twam/led-display-hardware/Rev1.0/led-matrix-cape.pdf

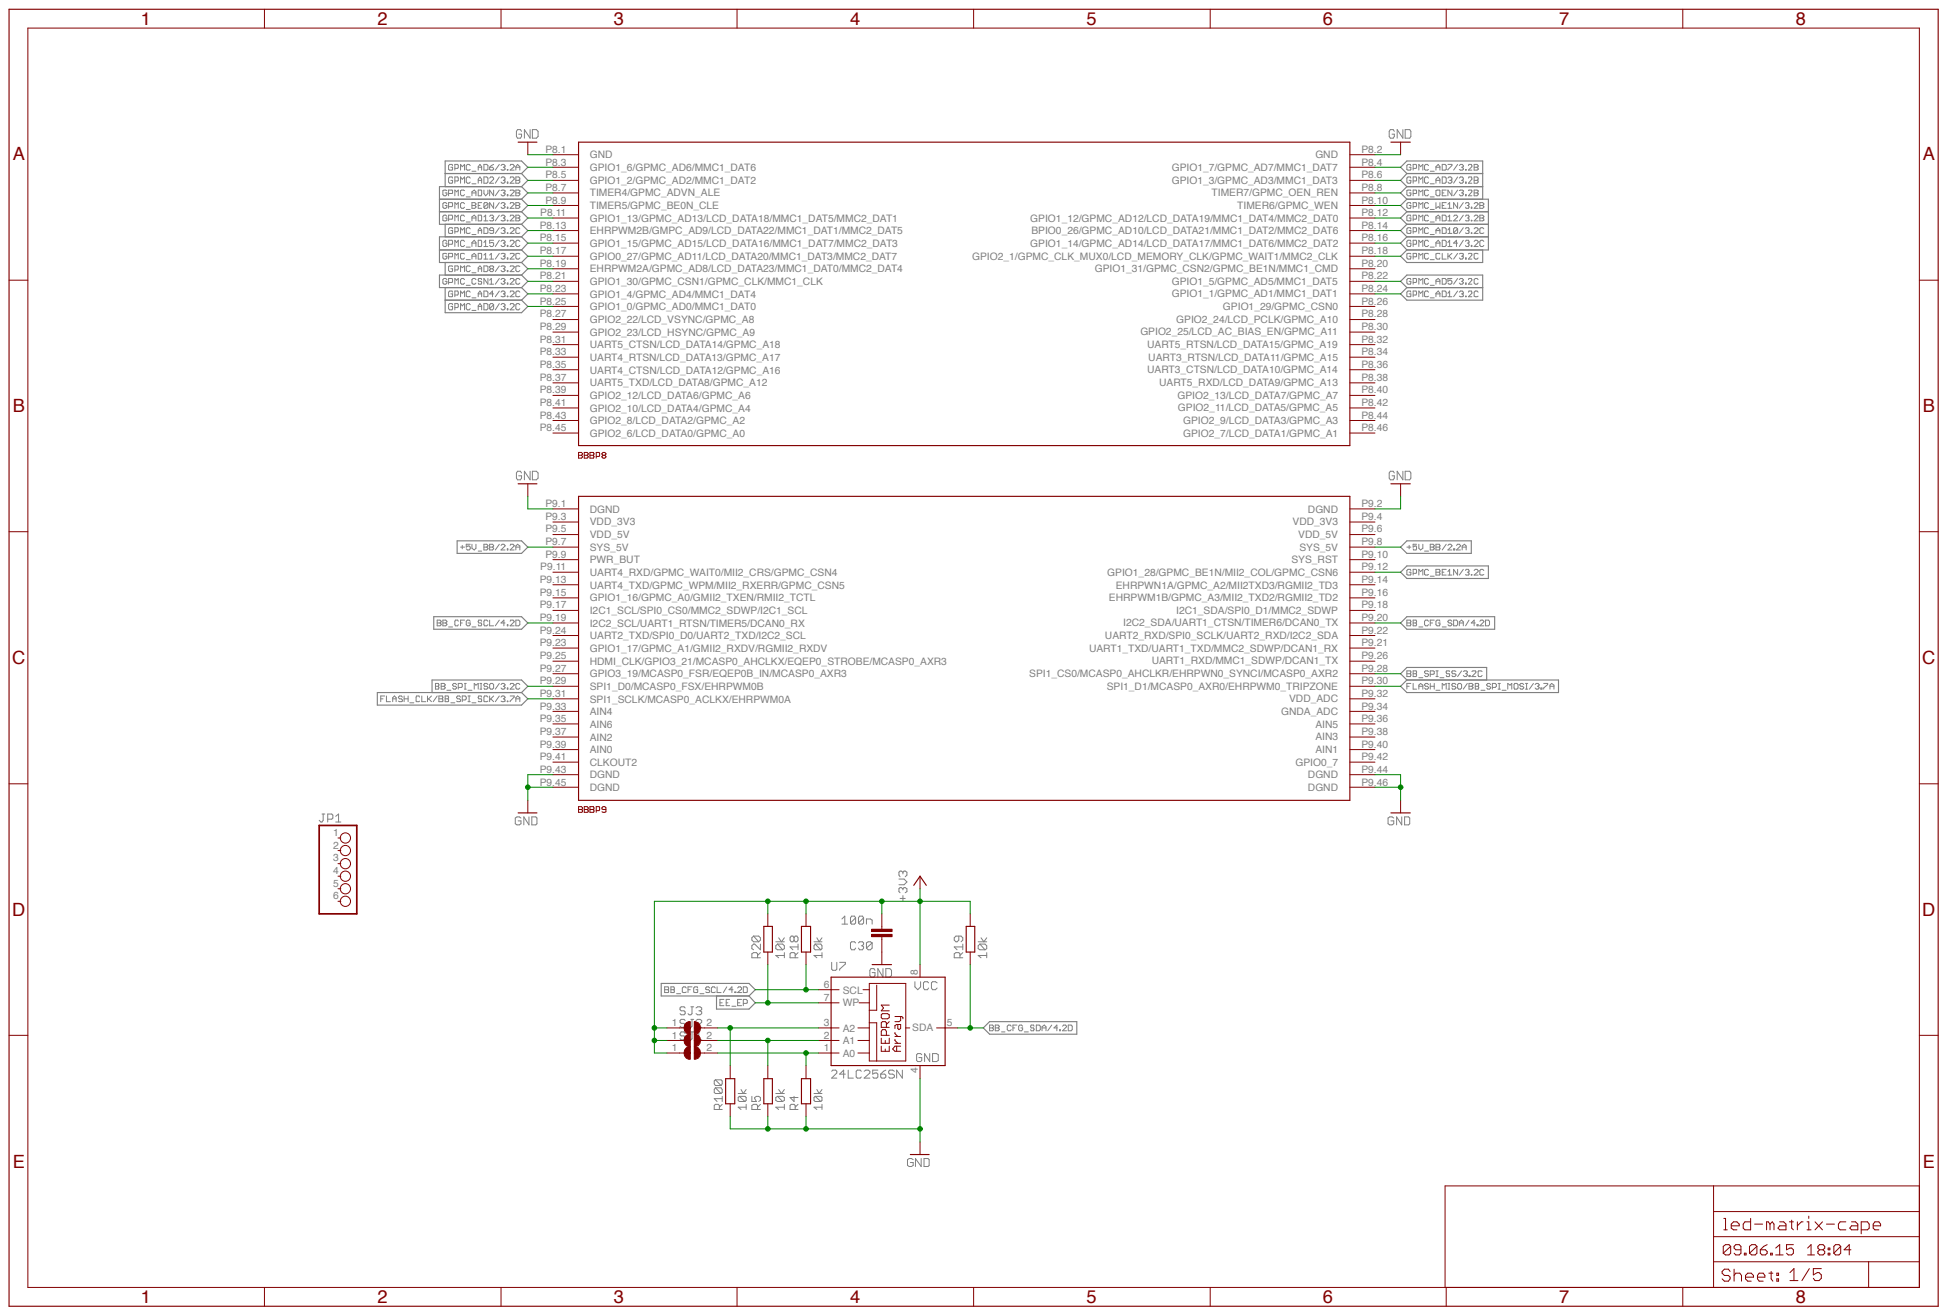
[picture p7: page 1]
SCL; SDA; GND P8.1 GPIO1_6/GPMC_AD6/MMC1_DAT6 P8.3 GPIO1_2/GPMC_AD2/MMC1_DAT2 P8.5 TIMER4/GPMC_ADVN_ALE P8.7 TIMER5/GPMC_BE0N_CLE P8.9 GPIO1_13/GPMC_AD13/LCD_DATA18/MMC1_DAT5/MMC2_DAT1 P8.11 EHRPWM2B/GMPC_AD9/LCD_DATA22/MMC1_DAT1/MMC2_DAT5 P8.13 GPIO1_15/GPMC_AD15/LCD_DATA16/MMC1_DAT7/MMC2_DAT3 P8.15 GPIO0_27/GPMC_AD11/LCD_DATA20/MMC1_DAT3/MMC2_DAT7 P8.17 EHRPWM2A/GPMC_AD8/LCD_DATA23/MMC1_DAT0/MMC2_DAT4 P8.19 GPIO1_30/GPMC_CSN1/GPMC_CLK/MMC1_CLK P8.21; GPIO1_0/GPMC_AD0/MMC1_DAT0 P8.25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

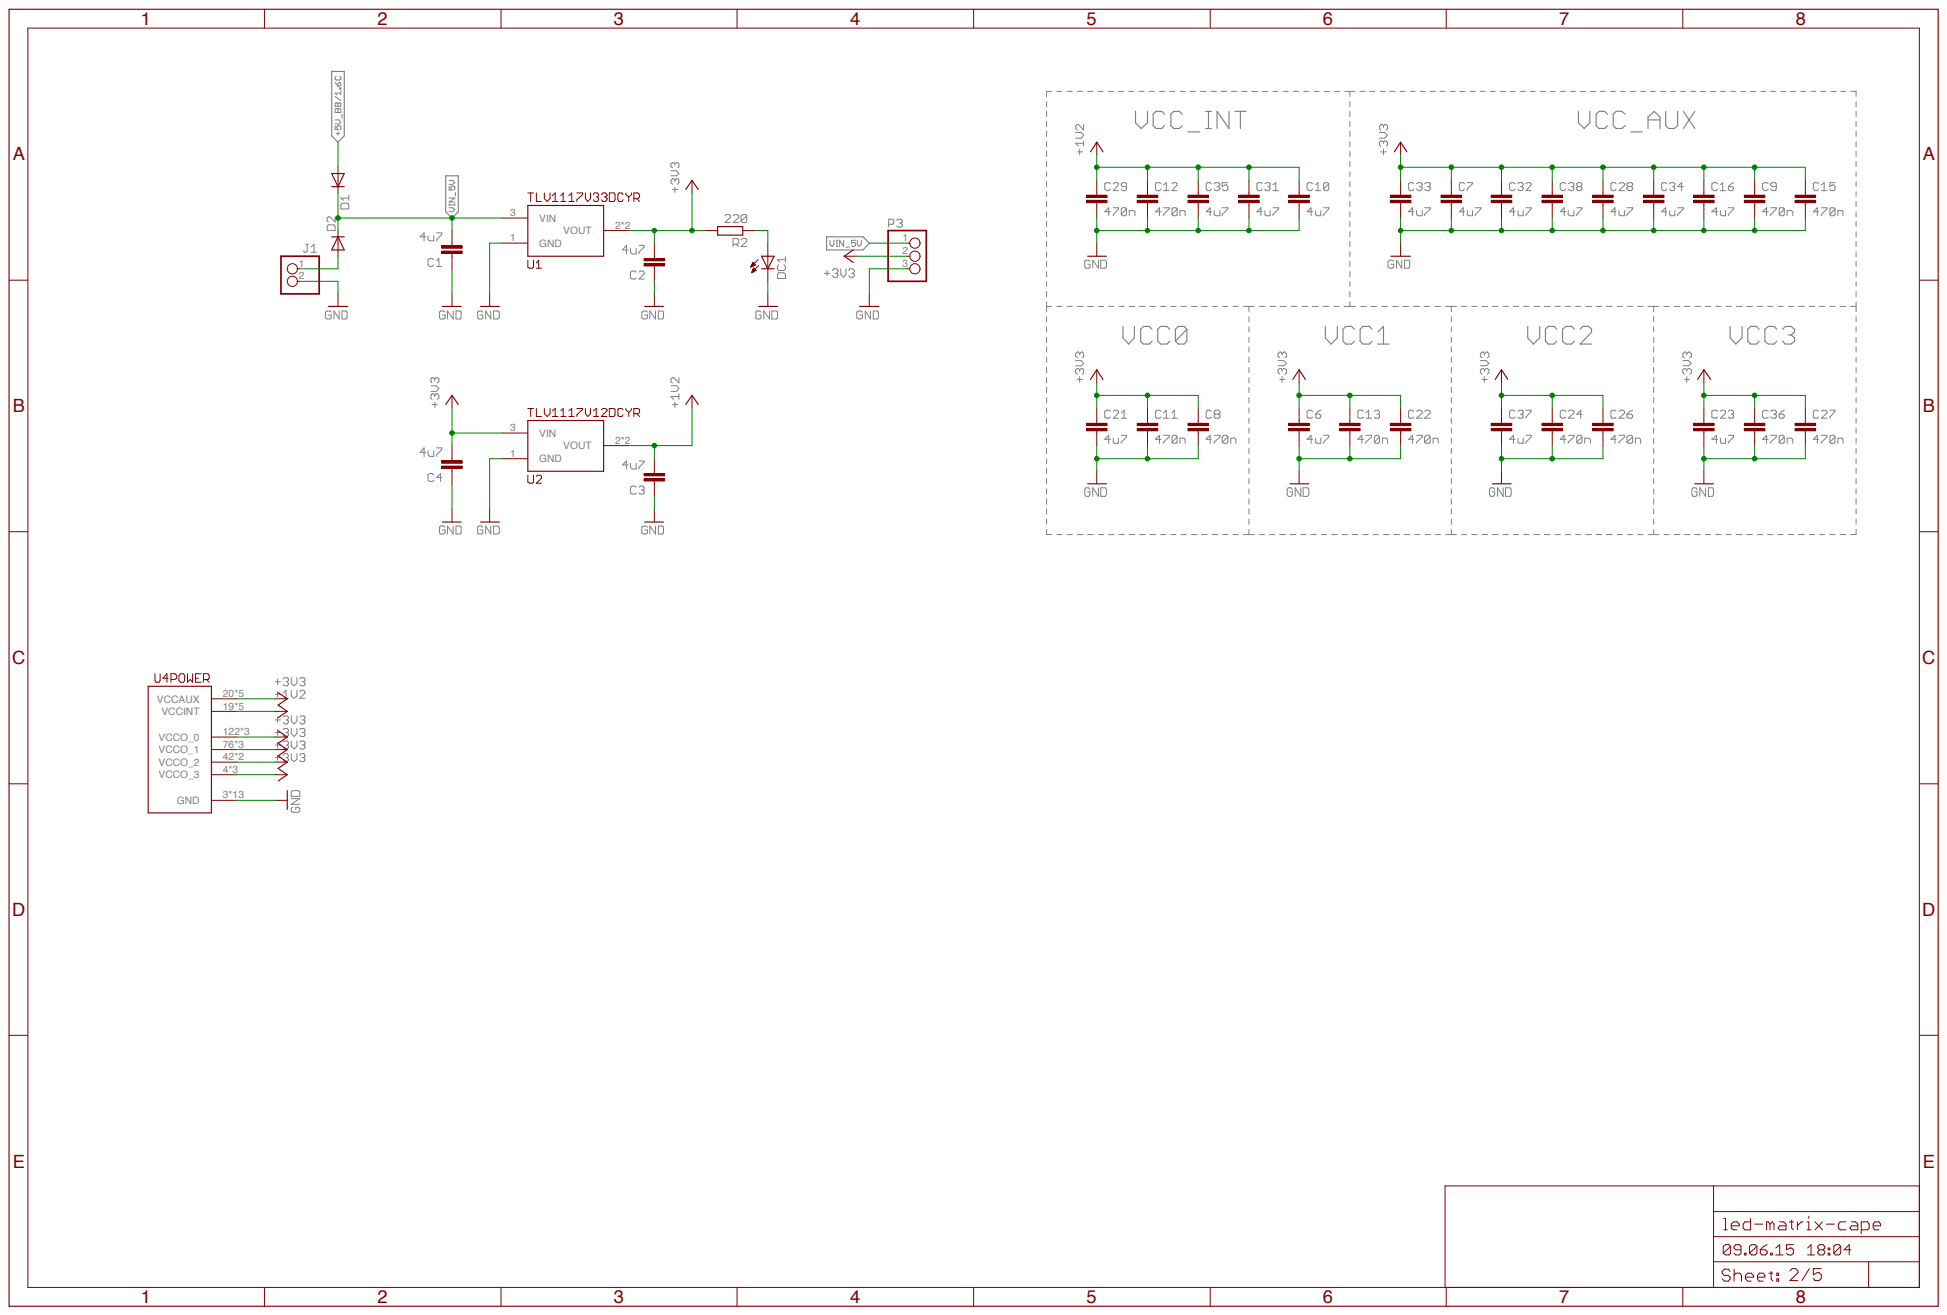
[picture p8: page 2]
GND; VCCAUX; VCCINT; VCCO_1; 76*3 VCCO_0; VCCO_2; VCCO_3; VIN; VOUT; ABCDE

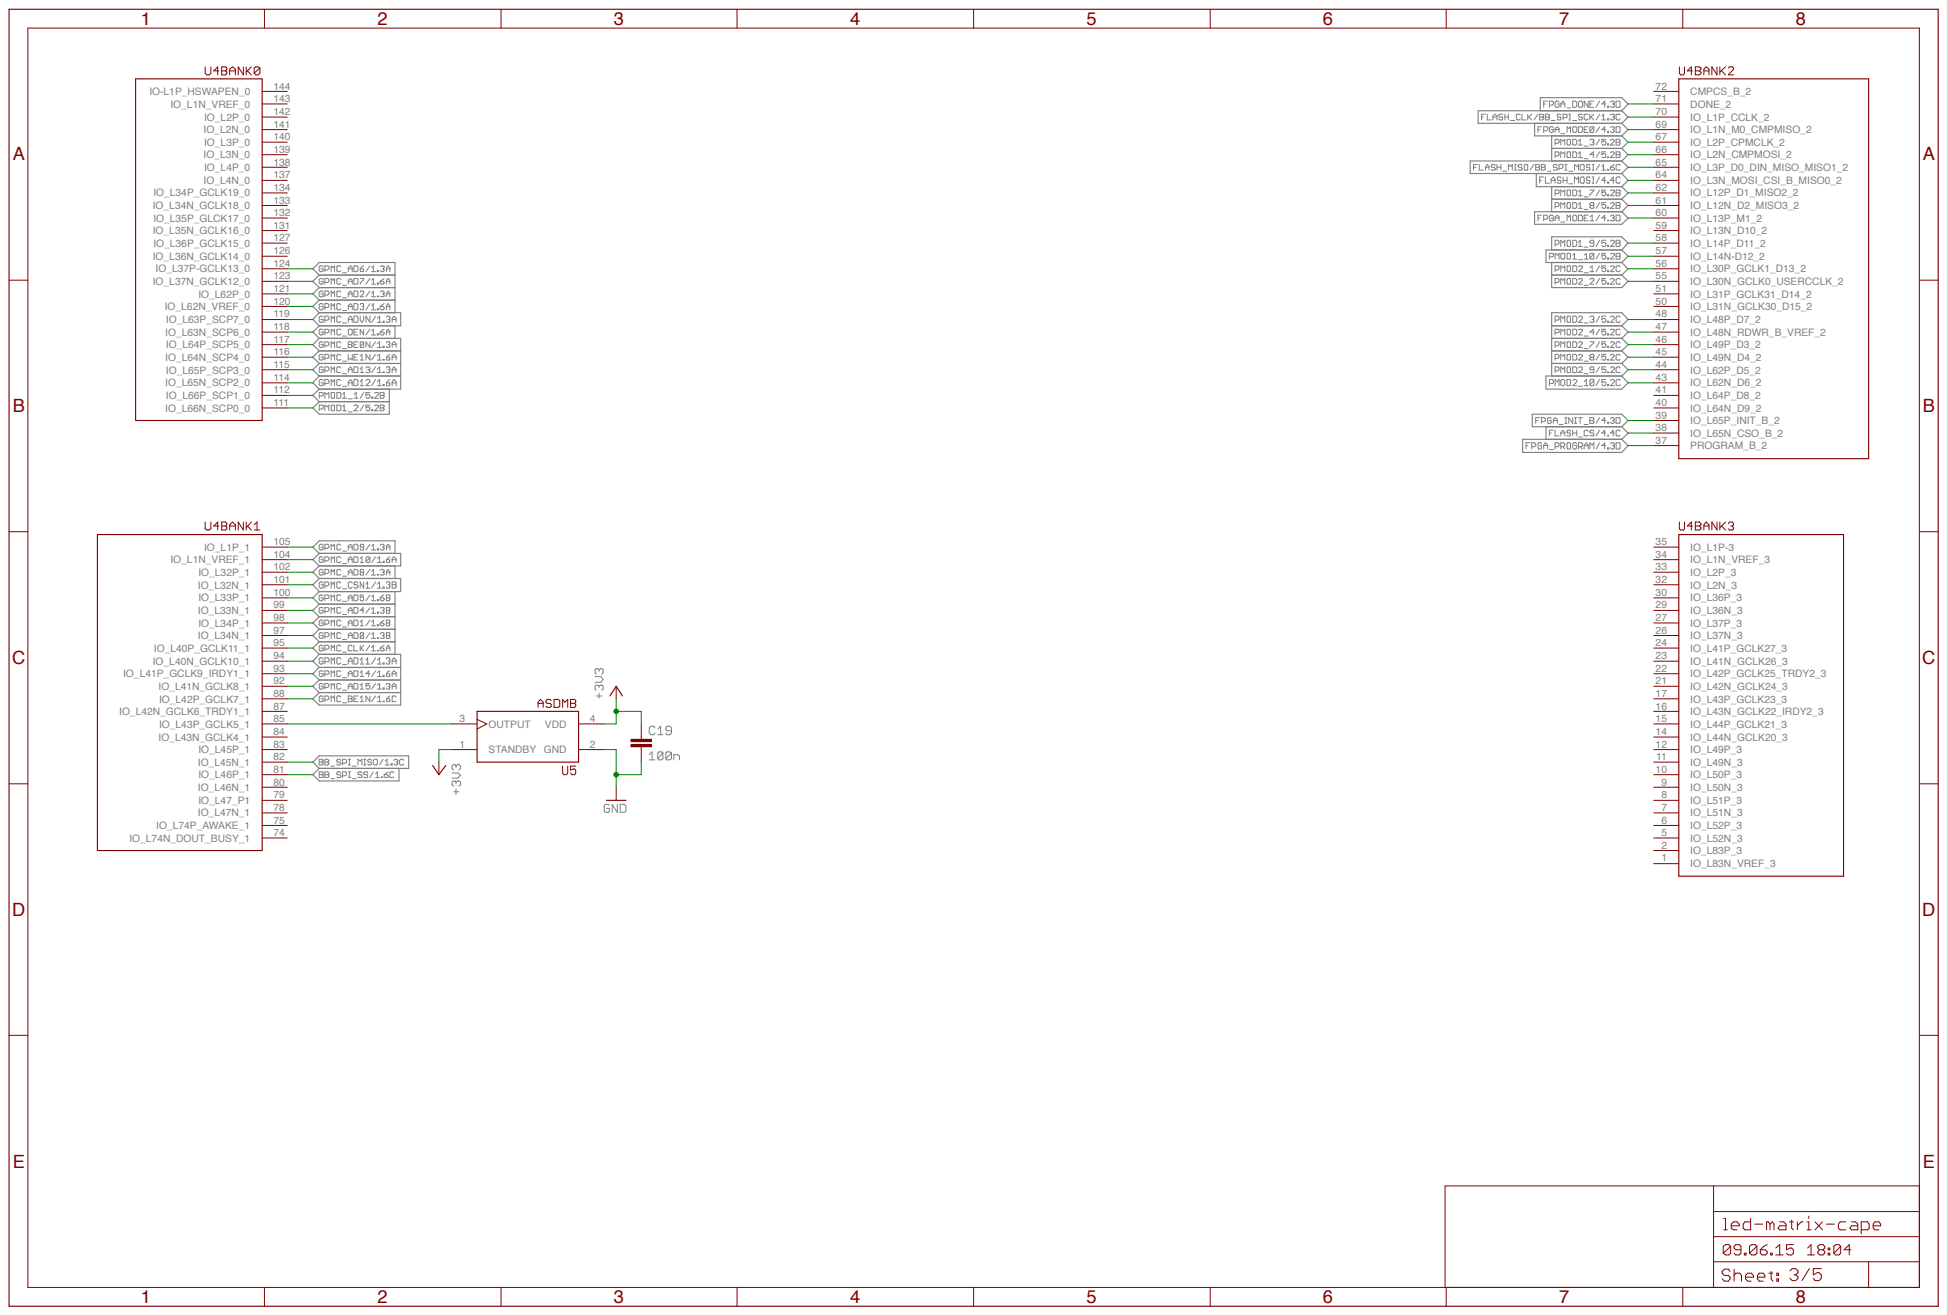
[picture p9: page 3]
IO-L1P_HSWAPEN_0; IO_L1N_VREF_0; IO_L34P_GCLK19_0; IO_L34N_GCLK18_0; IO_L35P_GLCK17_0; IO_L35N_GCLK16_0; IO_L36P_GCLK15_0; IO_L36N_GCLK14_0; IO_L37P-GCLK13_0; IO_L37N_GCLK12_0; IO_L62N_VREF_0; IO_L63P_SCP7_0; IO_L63N_SCP6_0; IO_L64P_SCP5_0; IO_L65P_SCP3_0; IO_L66P_SCP1_0; 112 IO_L65N_SCP2_0; IO_L64N_SCP4_0; IO_L66N_SCP0_0; IO_L1N_VREF_1; IO_L40P_GCLK11_1; IO_L40N_GCLK10_1; IO_L41P_GCLK9_IRDY1_1; IO_L41N_GCLK8_1; IO_L42P_GCLK7_1; IO_L42N_GCLK6_TRDY1_1; IO_L43P_GCLK5_1; IO_L43N_GCLK4_1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

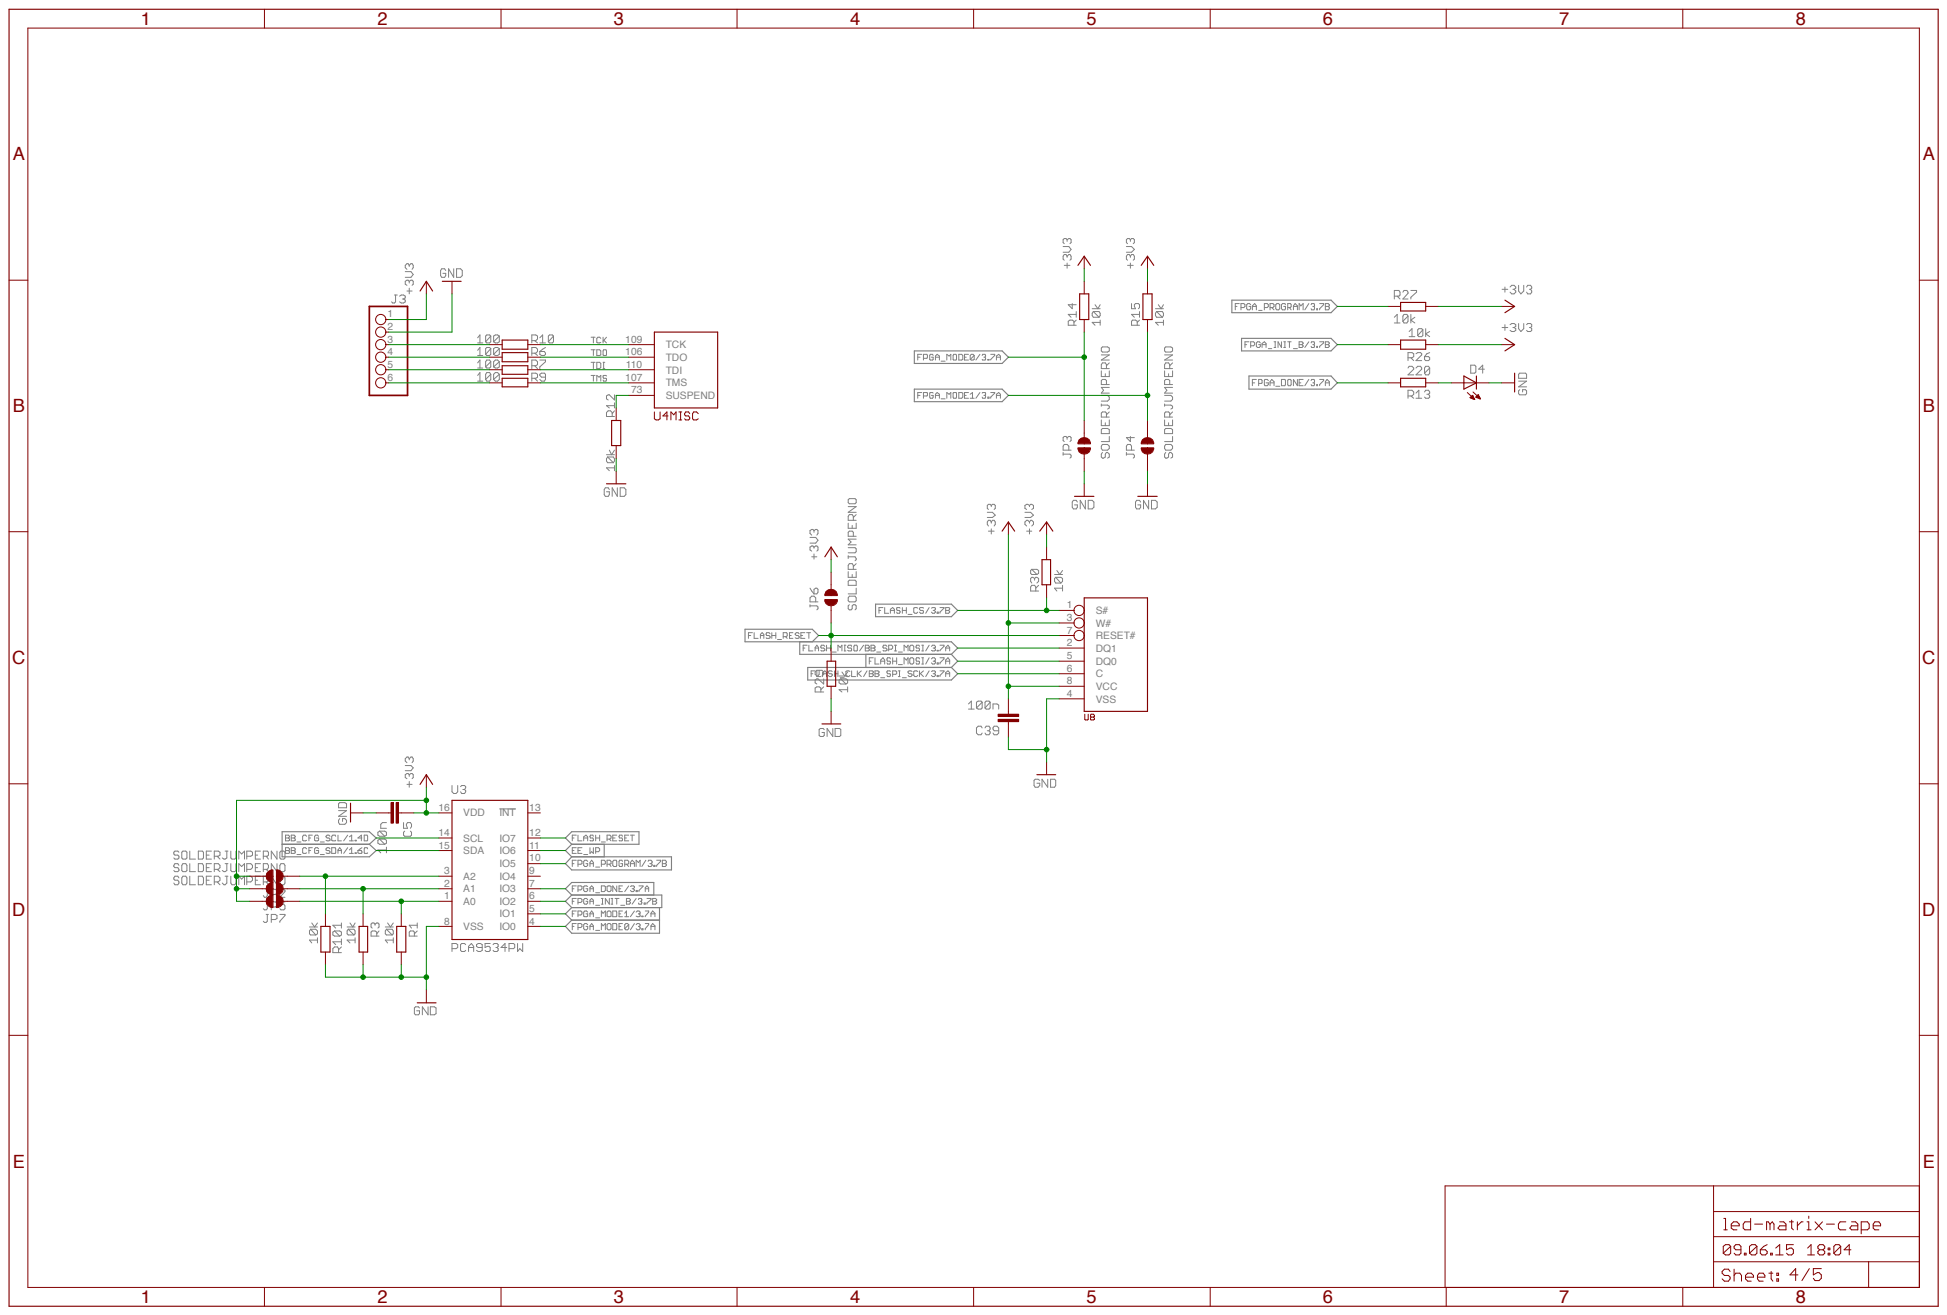
[picture p10: page 4]
RESET#; VCC; VSS; TCK 109; TDI 110; TDO 106; TMS 107 SUSPEND 73; VDD 16; SCL 14 SDA 15; INT; ABCDE

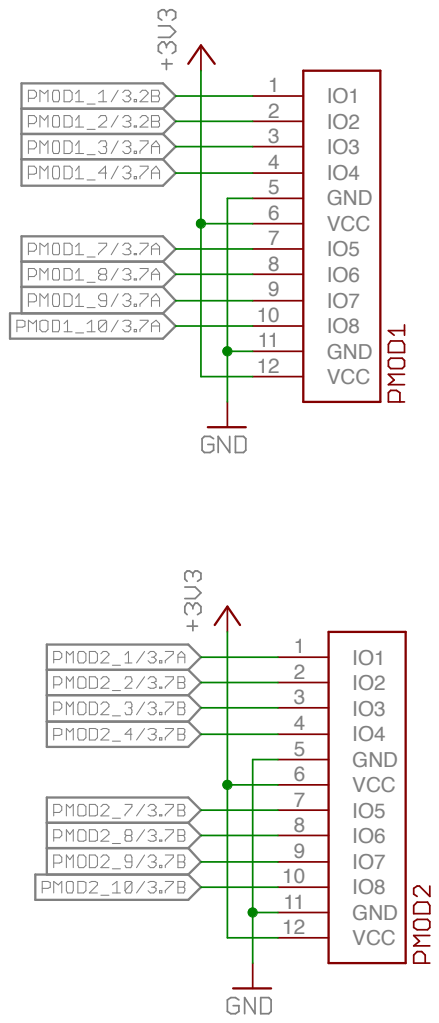
[picture p11: page 5]
GND; VCC; 9 IO8 10 GND 11 VCC 12; VCC 12; ABCDE

IO8 10
GND 11
