twam/led-display-hardware/Rev2.0/Rev2.0.kicad_pcb

## KiCad design Rev2.0/Rev2.0.kicad_pcb (2015-06-09)

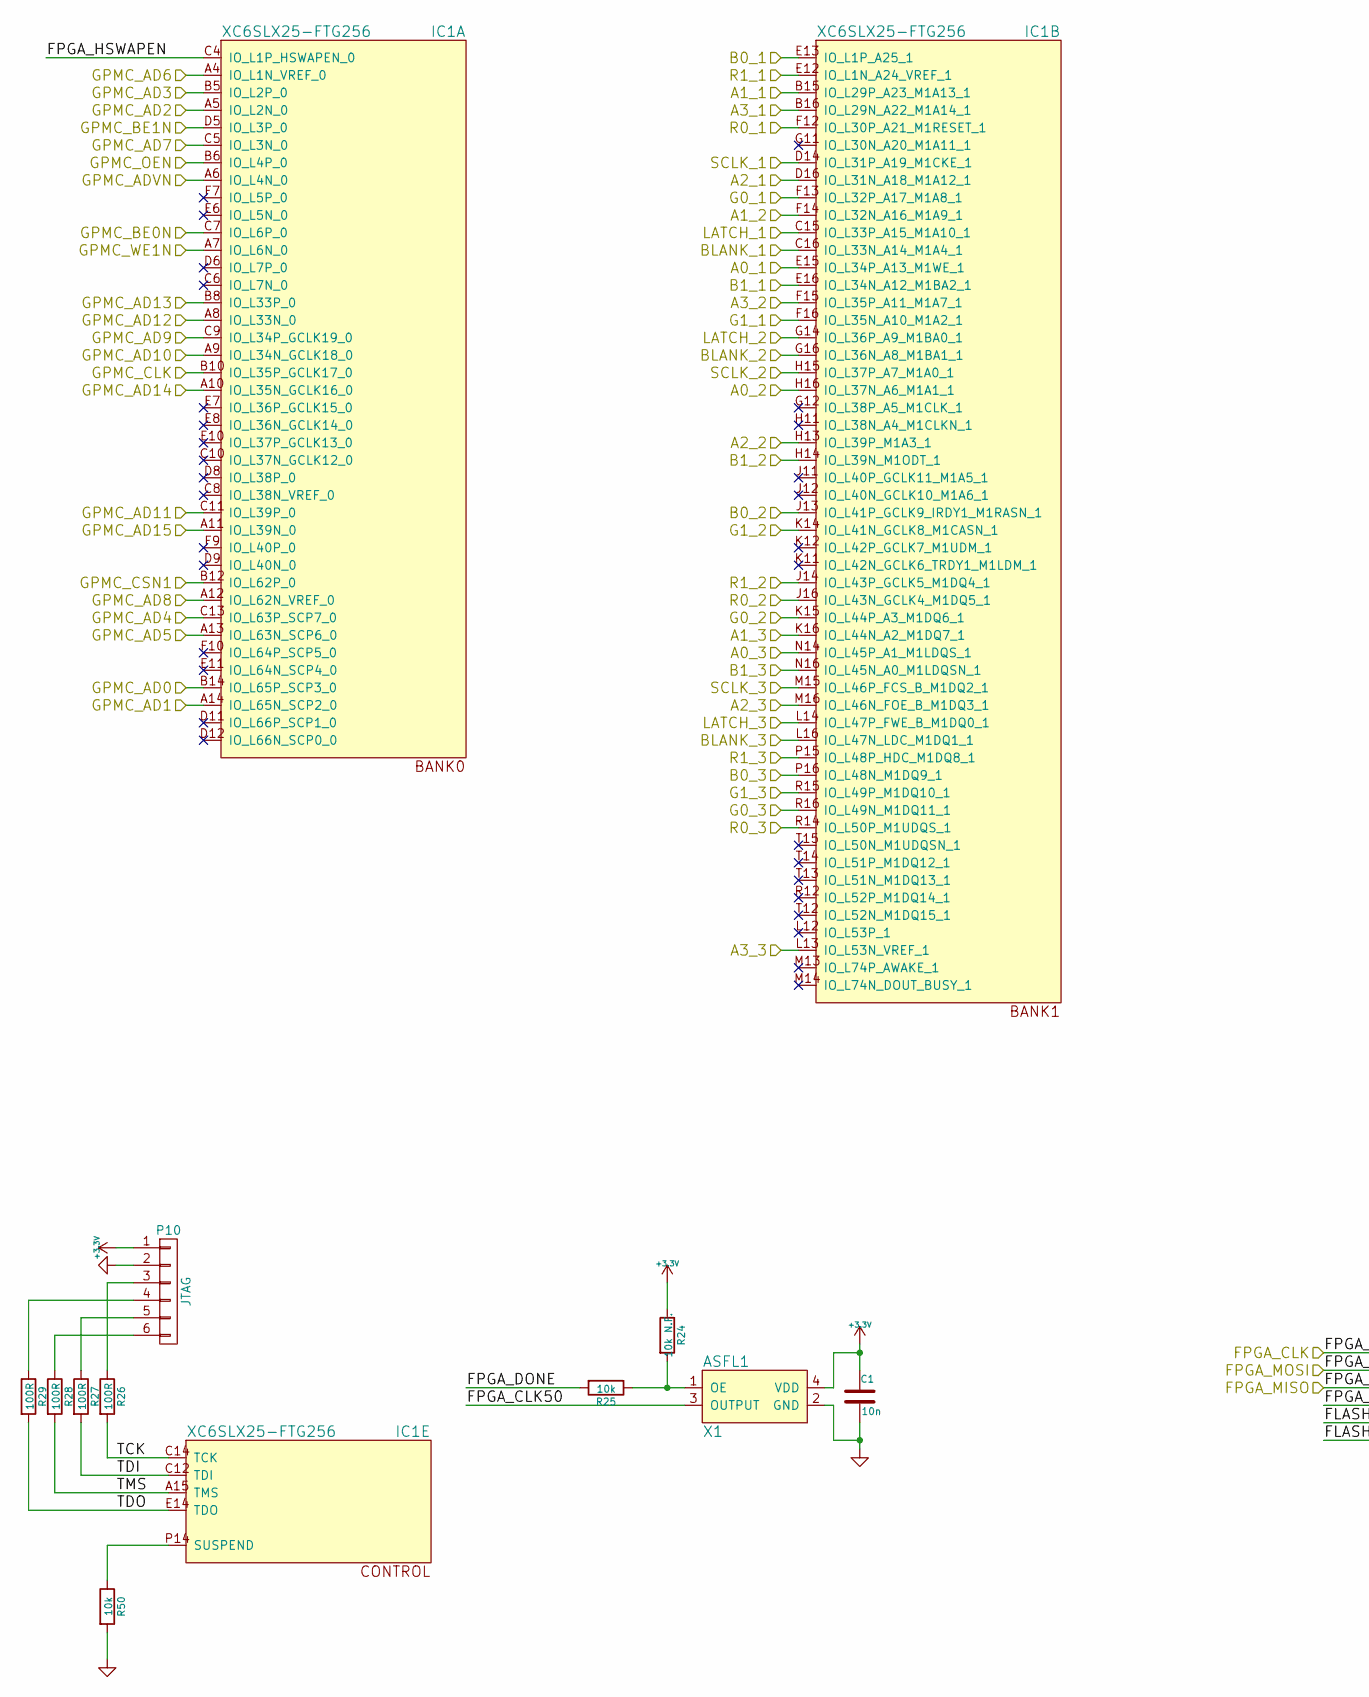
[picture p12: schematic fpga.sch, part in row 1, column 1]

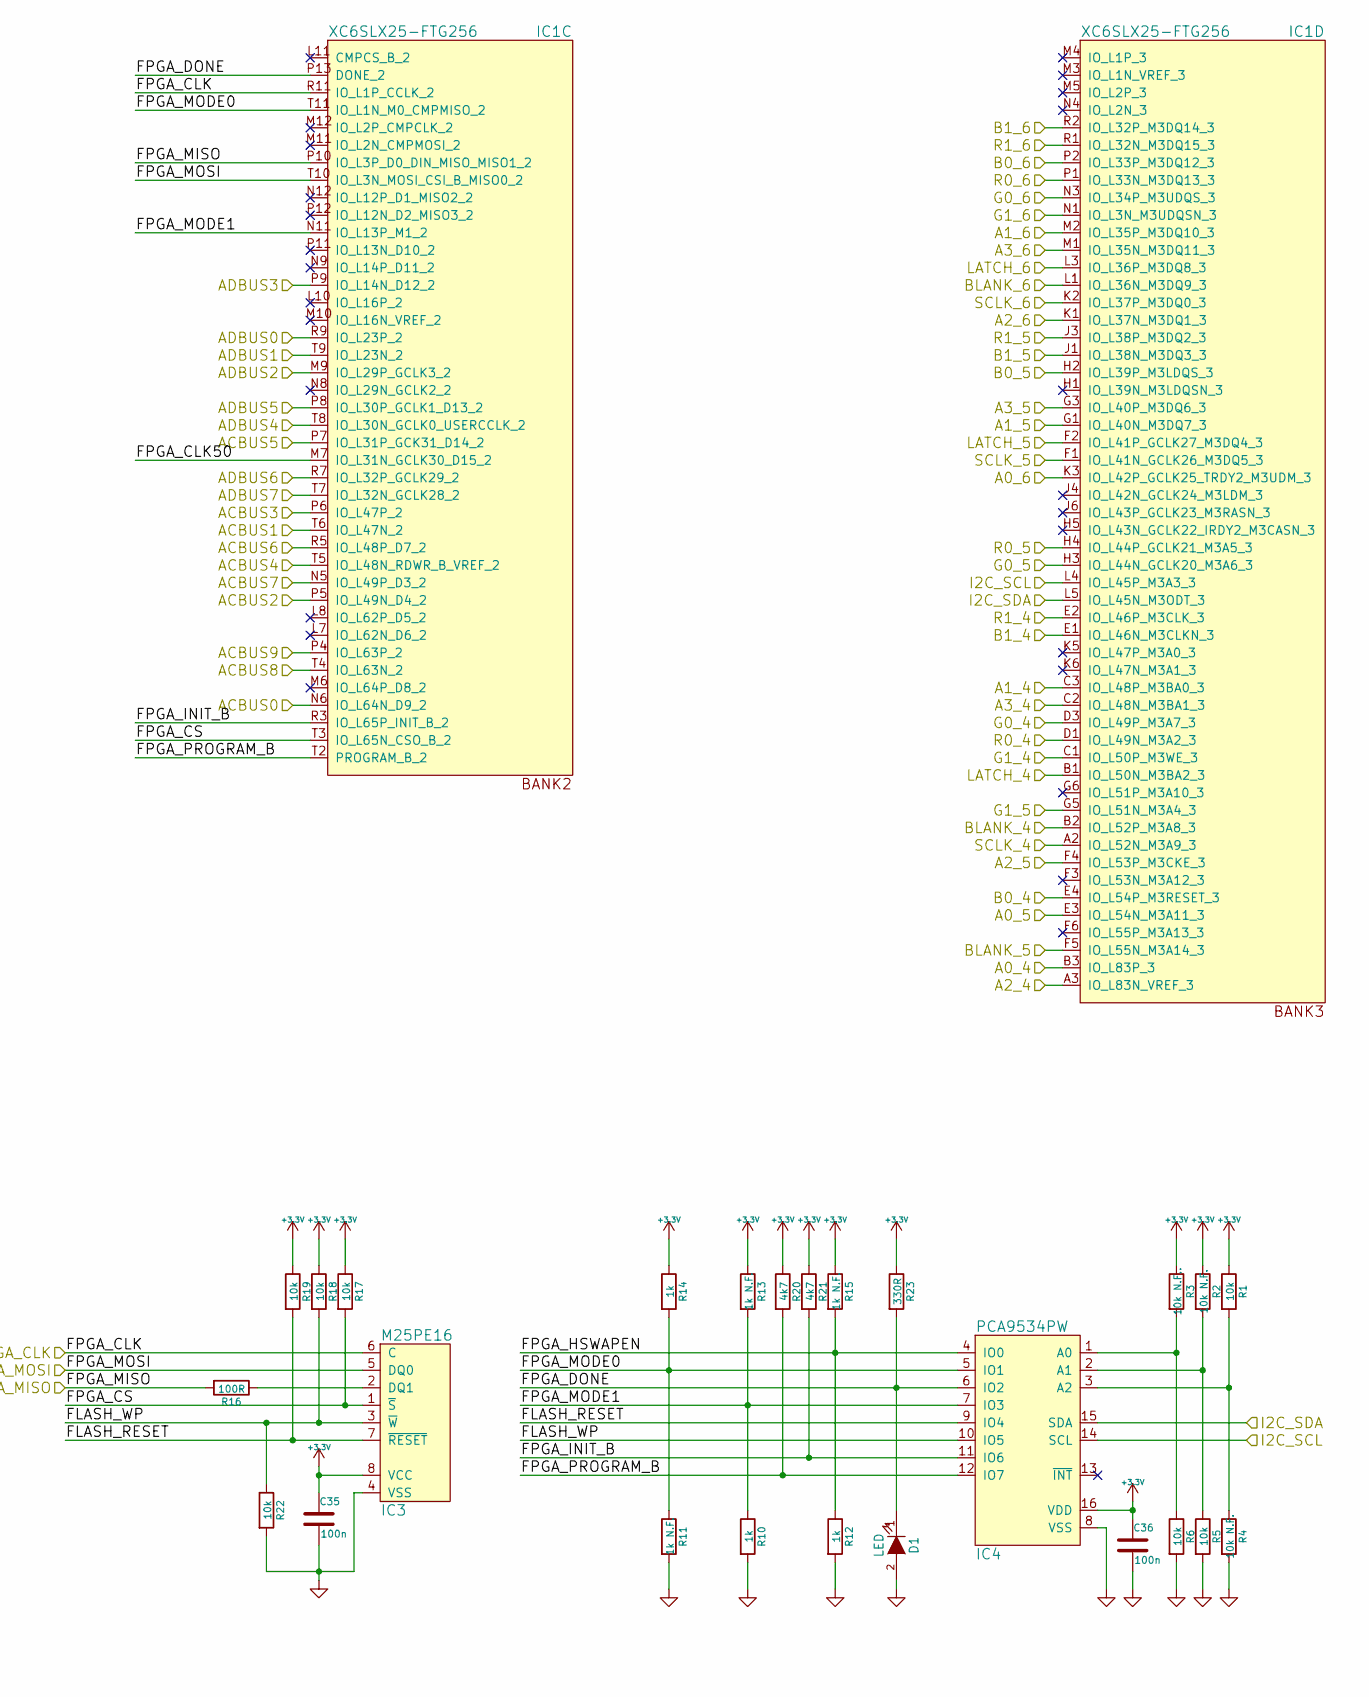
[picture p13: schematic fpga.sch, part in row 1, column 2]

Parts:
C1: 10n; C_0603
C35, C36: 100n; C_0603
D1: LED; LED-0603
IC1: XC6SLX25-FTG256; BGA-256
IC3: M25PE16; SO8W
IC4: PCA9534PW; TSSOP-16_4.4x5mm_Pitch0.65mm
P10: JTAG; Pin_Header_Straight_1x06
R1, R5, R6, R17, R18, R19, R22, R25, R50: 10k; R_0603
R2, R4, R24: 10k N.F.; R_0603
R3: 10k N.F..; R_0603
R10, R12, R14: 1k; R_0603
R11, R13, R15: 1k N.F.; R_0603
R16, R26, R27, R28, R29: 100R; R_0603
R20, R21: 4k7; R_0603
R23: 330R; R_0603
X1: ASFL1

Connections:
+3V3: C1.1, C35.1, C36.1, IC3.8 (VCC), IC4.16 (VDD), P10.1, R1.1, R2.1, R3.1, R13.1, R14.1, R15.1, R17.1, R18.1, R19.1, R20.1, R21.1, R23.1, R24.1, X1.4 (VDD); also elsewhere on the board
/BeagleBoneBlack/GPMC_AD0: IC1.B14 (IO_L65P_SCP3_0); also elsewhere on the board
/BeagleBoneBlack/GPMC_AD1: IC1.A14 (IO_L65N_SCP2_0); also elsewhere on the board
/BeagleBoneBlack/GPMC_AD2: IC1.A5 (IO_L2N_0); also elsewhere on the board
/BeagleBoneBlack/GPMC_AD3: IC1.B5 (IO_L2P_0); also elsewhere on the board
/BeagleBoneBlack/GPMC_AD4: IC1.C13 (IO_L63P_SCP7_0); also elsewhere on the board
/BeagleBoneBlack/GPMC_AD5: IC1.A13 (IO_L63N_SCP6_0); also elsewhere on the board
/BeagleBoneBlack/GPMC_AD6: IC1.A4 (IO_L1N_VREF_0); also elsewhere on the board
/BeagleBoneBlack/GPMC_AD7: IC1.C5 (IO_L3N_0); also elsewhere on the board
/BeagleBoneBlack/GPMC_AD8: IC1.A12 (IO_L62N_VREF_0); also elsewhere on the board
/BeagleBoneBlack/GPMC_AD9: IC1.C9 (IO_L34P_GCLK19_0); also elsewhere on the board
/BeagleBoneBlack/GPMC_AD10: IC1.A9 (IO_L34N_GCLK18_0); also elsewhere on the board
/BeagleBoneBlack/GPMC_AD11: IC1.C11 (IO_L39P_0); also elsewhere on the board
/BeagleBoneBlack/GPMC_AD12: IC1.A8 (IO_L33N_0); also elsewhere on the board
/BeagleBoneBlack/GPMC_AD13: IC1.B8 (IO_L33P_0); also elsewhere on the board
/BeagleBoneBlack/GPMC_AD14: IC1.A10 (IO_L35N_GCLK16_0); also elsewhere on the board
/BeagleBoneBlack/GPMC_AD15: IC1.A11 (IO_L39N_0); also elsewhere on the board
/BeagleBoneBlack/GPMC_ADVN: IC1.A6 (IO_L4N_0); also elsewhere on the board
/BeagleBoneBlack/GPMC_BE0N: IC1.C7 (IO_L6P_0); also elsewhere on the board
/BeagleBoneBlack/GPMC_BE1N: IC1.D5 (IO_L3P_0); also elsewhere on the board
/BeagleBoneBlack/GPMC_CLK: IC1.B10 (IO_L35P_GCLK17_0); also elsewhere on the board
/BeagleBoneBlack/GPMC_CSN1: IC1.B12 (IO_L62P_0); also elsewhere on the board
/BeagleBoneBlack/GPMC_OEN: IC1.B6 (IO_L4P_0); also elsewhere on the board
/BeagleBoneBlack/GPMC_WE1N: IC1.A7 (IO_L6N_0); also elsewhere on the board
/BeagleBoneBlack/I2C2_SCL: IC1.L4 (IO_L45P_M3A3_3), IC4.14 (SCL); also elsewhere on the board
/BeagleBoneBlack/I2C2_SDA: IC1.L5 (IO_L45N_M3ODT_3), IC4.15 (SDA); also elsewhere on the board
/FPGA/A0_1: IC1.E15 (IO_L34P_A13_M1WE_1); also elsewhere on the board
/FPGA/A0_2: IC1.H16 (IO_L37N_A6_M1A1_1); also elsewhere on the board
/FPGA/A0_3: IC1.N14 (IO_L45P_A1_M1LDQS_1); also elsewhere on the board
/FPGA/A0_4: IC1.B3 (IO_L83P_3); also elsewhere on the board
/FPGA/A0_5: IC1.E3 (IO_L54N_M3A11_3); also elsewhere on the board
/FPGA/A0_6: IC1.K3 (IO_L42P_GCLK25_TRDY2_M3UDM_3); also elsewhere on the board
/FPGA/A1_1: IC1.B15 (IO_L29P_A23_M1A13_1); also elsewhere on the board
/FPGA/A1_2: IC1.F14 (IO_L32N_A16_M1A9_1); also elsewhere on the board
/FPGA/A1_3: IC1.K16 (IO_L44N_A2_M1DQ7_1); also elsewhere on the board
/FPGA/A1_4: IC1.C3 (IO_L48P_M3BA0_3); also elsewhere on the board
/FPGA/A1_5: IC1.G1 (IO_L40N_M3DQ7_3); also elsewhere on the board
/FPGA/A1_6: IC1.M2 (IO_L35P_M3DQ10_3); also elsewhere on the board
/FPGA/A2_1: IC1.D16 (IO_L31N_A18_M1A12_1); also elsewhere on the board
/FPGA/A2_2: IC1.H13 (IO_L39P_M1A3_1); also elsewhere on the board
/FPGA/A2_3: IC1.M16 (IO_L46N_FOE_B_M1DQ3_1); also elsewhere on the board
/FPGA/A2_4: IC1.A3 (IO_L83N_VREF_3); also elsewhere on the board
/FPGA/A2_5: IC1.F4 (IO_L53P_M3CKE_3); also elsewhere on the board
/FPGA/A2_6: IC1.K1 (IO_L37N_M3DQ1_3); also elsewhere on the board
/FPGA/A3_1: IC1.B16 (IO_L29N_A22_M1A14_1); also elsewhere on the board
/FPGA/A3_2: IC1.F15 (IO_L35P_A11_M1A7_1); also elsewhere on the board
/FPGA/A3_3: IC1.L13 (IO_L53N_VREF_1); also elsewhere on the board
/FPGA/A3_4: IC1.C2 (IO_L48N_M3BA1_3); also elsewhere on the board
/FPGA/A3_5: IC1.G3 (IO_L40P_M3DQ6_3); also elsewhere on the board
/FPGA/A3_6: IC1.M1 (IO_L35N_M3DQ11_3); also elsewhere on the board
/FPGA/ACBUS0: IC1.N6 (IO_L64N_D9_2); also elsewhere on the board
/FPGA/ACBUS1: IC1.T6 (IO_L47N_2); also elsewhere on the board
/FPGA/ACBUS2: IC1.P5 (IO_L49N_D4_2); also elsewhere on the board
/FPGA/ACBUS3: IC1.P6 (IO_L47P_2); also elsewhere on the board
/FPGA/ACBUS4: IC1.T5 (IO_L48N_RDWR_B_VREF_2); also elsewhere on the board
/FPGA/ACBUS5: IC1.P7 (IO_L31P_GCK31_D14_2); also elsewhere on the board
/FPGA/ACBUS6: IC1.R5 (IO_L48P_D7_2); also elsewhere on the board
/FPGA/ACBUS7: IC1.N5 (IO_L49P_D3_2); also elsewhere on the board
/FPGA/ACBUS8: IC1.T4 (IO_L63N_2); also elsewhere on the board
/FPGA/ACBUS9: IC1.P4 (IO_L63P_2); also elsewhere on the board
/FPGA/ADBUS0: IC1.R9 (IO_L23P_2); also elsewhere on the board
/FPGA/ADBUS1: IC1.T9 (IO_L23N_2); also elsewhere on the board
/FPGA/ADBUS2: IC1.M9 (IO_L29P_GCLK3_2); also elsewhere on the board
/FPGA/ADBUS3: IC1.P9 (IO_L14N_D12_2); also elsewhere on the board
/FPGA/ADBUS4: IC1.T8 (IO_L30N_GCLK0_USERCCLK_2); also elsewhere on the board
/FPGA/ADBUS5: IC1.P8 (IO_L30P_GCLK1_D13_2); also elsewhere on the board
/FPGA/ADBUS6: IC1.R7 (IO_L32P_GCLK29_2); also elsewhere on the board
/FPGA/ADBUS7: IC1.T7 (IO_L32N_GCLK28_2); also elsewhere on the board
/FPGA/B0_1: IC1.E13 (IO_L1P_A25_1); also elsewhere on the board
/FPGA/B0_2: IC1.J13 (IO_L41P_GCLK9_IRDY1_M1RASN_1); also elsewhere on the board
/FPGA/B0_3: IC1.P16 (IO_L48N_M1DQ9_1); also elsewhere on the board
/FPGA/B0_4: IC1.E4 (IO_L54P_M3RESET_3); also elsewhere on the board
/FPGA/B0_5: IC1.H2 (IO_L39P_M3LDQS_3); also elsewhere on the board
/FPGA/B0_6: IC1.P2 (IO_L33P_M3DQ12_3); also elsewhere on the board
/FPGA/B1_1: IC1.E16 (IO_L34N_A12_M1BA2_1); also elsewhere on the board
/FPGA/B1_2: IC1.H14 (IO_L39N_M1ODT_1); also elsewhere on the board
/FPGA/B1_3: IC1.N16 (IO_L45N_A0_M1LDQSN_1); also elsewhere on the board
/FPGA/B1_4: IC1.E1 (IO_L46N_M3CLKN_3); also elsewhere on the board
/FPGA/B1_5: IC1.J1 (IO_L38N_M3DQ3_3); also elsewhere on the board
/FPGA/B1_6: IC1.R2 (IO_L32P_M3DQ14_3); also elsewhere on the board
/FPGA/BLANK_1: IC1.C16 (IO_L33N_A14_M1A4_1); also elsewhere on the board
/FPGA/BLANK_2: IC1.G16 (IO_L36N_A8_M1BA1_1); also elsewhere on the board
/FPGA/BLANK_3: IC1.L16 (IO_L47N_LDC_M1DQ1_1); also elsewhere on the board
/FPGA/BLANK_4: IC1.B2 (IO_L52P_M3A8_3); also elsewhere on the board
/FPGA/BLANK_5: IC1.F5 (IO_L55N_M3A14_3); also elsewhere on the board
/FPGA/BLANK_6: IC1.L1 (IO_L36N_M3DQ9_3); also elsewhere on the board
/FPGA/FLASH_RESET: IC3.7 (~RESET), IC4.9 (IO4), R19.2
/FPGA/FLASH_WP: IC3.3 (~W), IC4.10 (IO5), R18.2, R22.1
/FPGA/FPGA_CLK: IC1.R11 (IO_L1P_CCLK_2), IC3.6 (C); also elsewhere on the board
/FPGA/FPGA_CLK50: IC1.M7 (IO_L31N_GCLK30_D15_2), X1.3 (OUTPUT)
/FPGA/FPGA_CS: IC1.T3 (IO_L65N_CSO_B_2), IC3.1 (~S), R17.2
/FPGA/FPGA_DONE: D1.1 (K), IC1.P13 (DONE_2), IC4.6 (IO2), R23.2, R25.2
/FPGA/FPGA_HSWAPEN: IC1.C4 (IO_L1P_HSWAPEN_0), IC4.4 (IO0), R12.1, R15.2
/FPGA/FPGA_INIT_B: IC1.R3 (IO_L65P_INIT_B_2), IC4.11 (IO6), R21.2
/FPGA/FPGA_MISO: IC1.P10 (IO_L3P_D0_DIN_MISO_MISO1_2), R16.2; also elsewhere on the board
/FPGA/FPGA_MODE0: IC1.T11 (IO_L1N_M0_CMPMISO_2), IC4.5 (IO1), R11.1, R14.2
/FPGA/FPGA_MODE1: IC1.N11 (IO_L13P_M1_2), IC4.7 (IO3), R10.1, R13.2
/FPGA/FPGA_MOSI: IC1.T10 (IO_L3N_MOSI_CSI_B_MISO0_2), IC3.5 (DQ0); also elsewhere on the board
/FPGA/FPGA_PROGRAM_B: IC1.T2 (PROGRAM_B_2), IC4.12 (IO7), R20.2
/FPGA/G0_1: IC1.F13 (IO_L32P_A17_M1A8_1); also elsewhere on the board
/FPGA/G0_2: IC1.K15 (IO_L44P_A3_M1DQ6_1); also elsewhere on the board
/FPGA/G0_3: IC1.R16 (IO_L49N_M1DQ11_1); also elsewhere on the board
/FPGA/G0_4: IC1.D3 (IO_L49P_M3A7_3); also elsewhere on the board
/FPGA/G0_5: IC1.H3 (IO_L44N_GCLK20_M3A6_3); also elsewhere on the board
/FPGA/G0_6: IC1.N3 (IO_L34P_M3UDQS_3); also elsewhere on the board
/FPGA/G1_1: IC1.F16 (IO_L35N_A10_M1A2_1); also elsewhere on the board
/FPGA/G1_2: IC1.K14 (IO_L41N_GCLK8_M1CASN_1); also elsewhere on the board
/FPGA/G1_3: IC1.R15 (IO_L49P_M1DQ10_1); also elsewhere on the board
/FPGA/G1_4: IC1.C1 (IO_L50P_M3WE_3); also elsewhere on the board
/FPGA/G1_5: IC1.G5 (IO_L51N_M3A4_3); also elsewhere on the board
/FPGA/G1_6: IC1.N1 (IO_L3N_M3UDQSN_3); also elsewhere on the board
/FPGA/LATCH_1: IC1.C15 (IO_L33P_A15_M1A10_1); also elsewhere on the board
/FPGA/LATCH_2: IC1.G14 (IO_L36P_A9_M1BA0_1); also elsewhere on the board
/FPGA/LATCH_3: IC1.L14 (IO_L47P_FWE_B_M1DQ0_1); also elsewhere on the board
/FPGA/LATCH_4: IC1.B1 (IO_L50N_M3BA2_3); also elsewhere on the board
/FPGA/LATCH_5: IC1.F2 (IO_L41P_GCLK27_M3DQ4_3); also elsewhere on the board
/FPGA/LATCH_6: IC1.L3 (IO_L36P_M3DQ8_3); also elsewhere on the board
/FPGA/R0_1: IC1.F12 (IO_L30P_A21_M1RESET_1); also elsewhere on the board
/FPGA/R0_2: IC1.J16 (IO_L43N_GCLK4_M1DQ5_1); also elsewhere on the board
/FPGA/R0_3: IC1.R14 (IO_L50P_M1UDQS_1); also elsewhere on the board
/FPGA/R0_4: IC1.D1 (IO_L49N_M3A2_3); also elsewhere on the board
/FPGA/R0_5: IC1.H4 (IO_L44P_GCLK21_M3A5_3); also elsewhere on the board
/FPGA/R0_6: IC1.P1 (IO_L33N_M3DQ13_3); also elsewhere on the board
/FPGA/R1_1: IC1.E12 (IO_L1N_A24_VREF_1); also elsewhere on the board
/FPGA/R1_2: IC1.J14 (IO_L43P_GCLK5_M1DQ4_1); also elsewhere on the board
/FPGA/R1_3: IC1.P15 (IO_L48P_HDC_M1DQ8_1); also elsewhere on the board
/FPGA/R1_4: IC1.E2 (IO_L46P_M3CLK_3); also elsewhere on the board
/FPGA/R1_5: IC1.J3 (IO_L38P_M3DQ2_3); also elsewhere on the board
/FPGA/R1_6: IC1.R1 (IO_L32N_M3DQ15_3); also elsewhere on the board
/FPGA/SCLK_1: IC1.D14 (IO_L31P_A19_M1CKE_1); also elsewhere on the board
/FPGA/SCLK_2: IC1.H15 (IO_L37P_A7_M1A0_1); also elsewhere on the board
/FPGA/SCLK_3: IC1.M15 (IO_L46P_FCS_B_M1DQ2_1); also elsewhere on the board
/FPGA/SCLK_4: IC1.A2 (IO_L52N_M3A9_3); also elsewhere on the board
/FPGA/SCLK_5: IC1.F1 (IO_L41N_GCLK26_M3DQ5_3); also elsewhere on the board
/FPGA/SCLK_6: IC1.K2 (IO_L37P_M3DQ0_3); also elsewhere on the board
/FPGA/TCK: IC1.C14 (TCK), R26.2
/FPGA/TDI: IC1.C12 (TDI), R27.2
/FPGA/TDO: IC1.E14 (TDO), R29.2
/FPGA/TMS: IC1.A15 (TMS), R28.2
GND: C1.2, C35.2, C36.2, D1.2 (A), IC3.4 (VSS), IC4.8 (VSS), P10.2, R4.2, R5.2, R6.2, R10.2, R11.2, R12.2, R22.2, R50.2, X1.2 (GND); also elsewhere on the board
unnamed: IC1.P14 (SUSPEND), R50.1
unnamed: IC3.2 (DQ1), R16.1
unnamed: IC4.1 (A0), R3.2, R6.1
unnamed: IC4.2 (A1), R2.2, R5.1
unnamed: IC4.3 (A2), R1.2, R4.1
unnamed: P10.3, R26.1
unnamed: P10.4, R29.1
unnamed: P10.5, R27.1
unnamed: P10.6, R28.1
unnamed: R24.2, R25.1, X1.1 (OE)

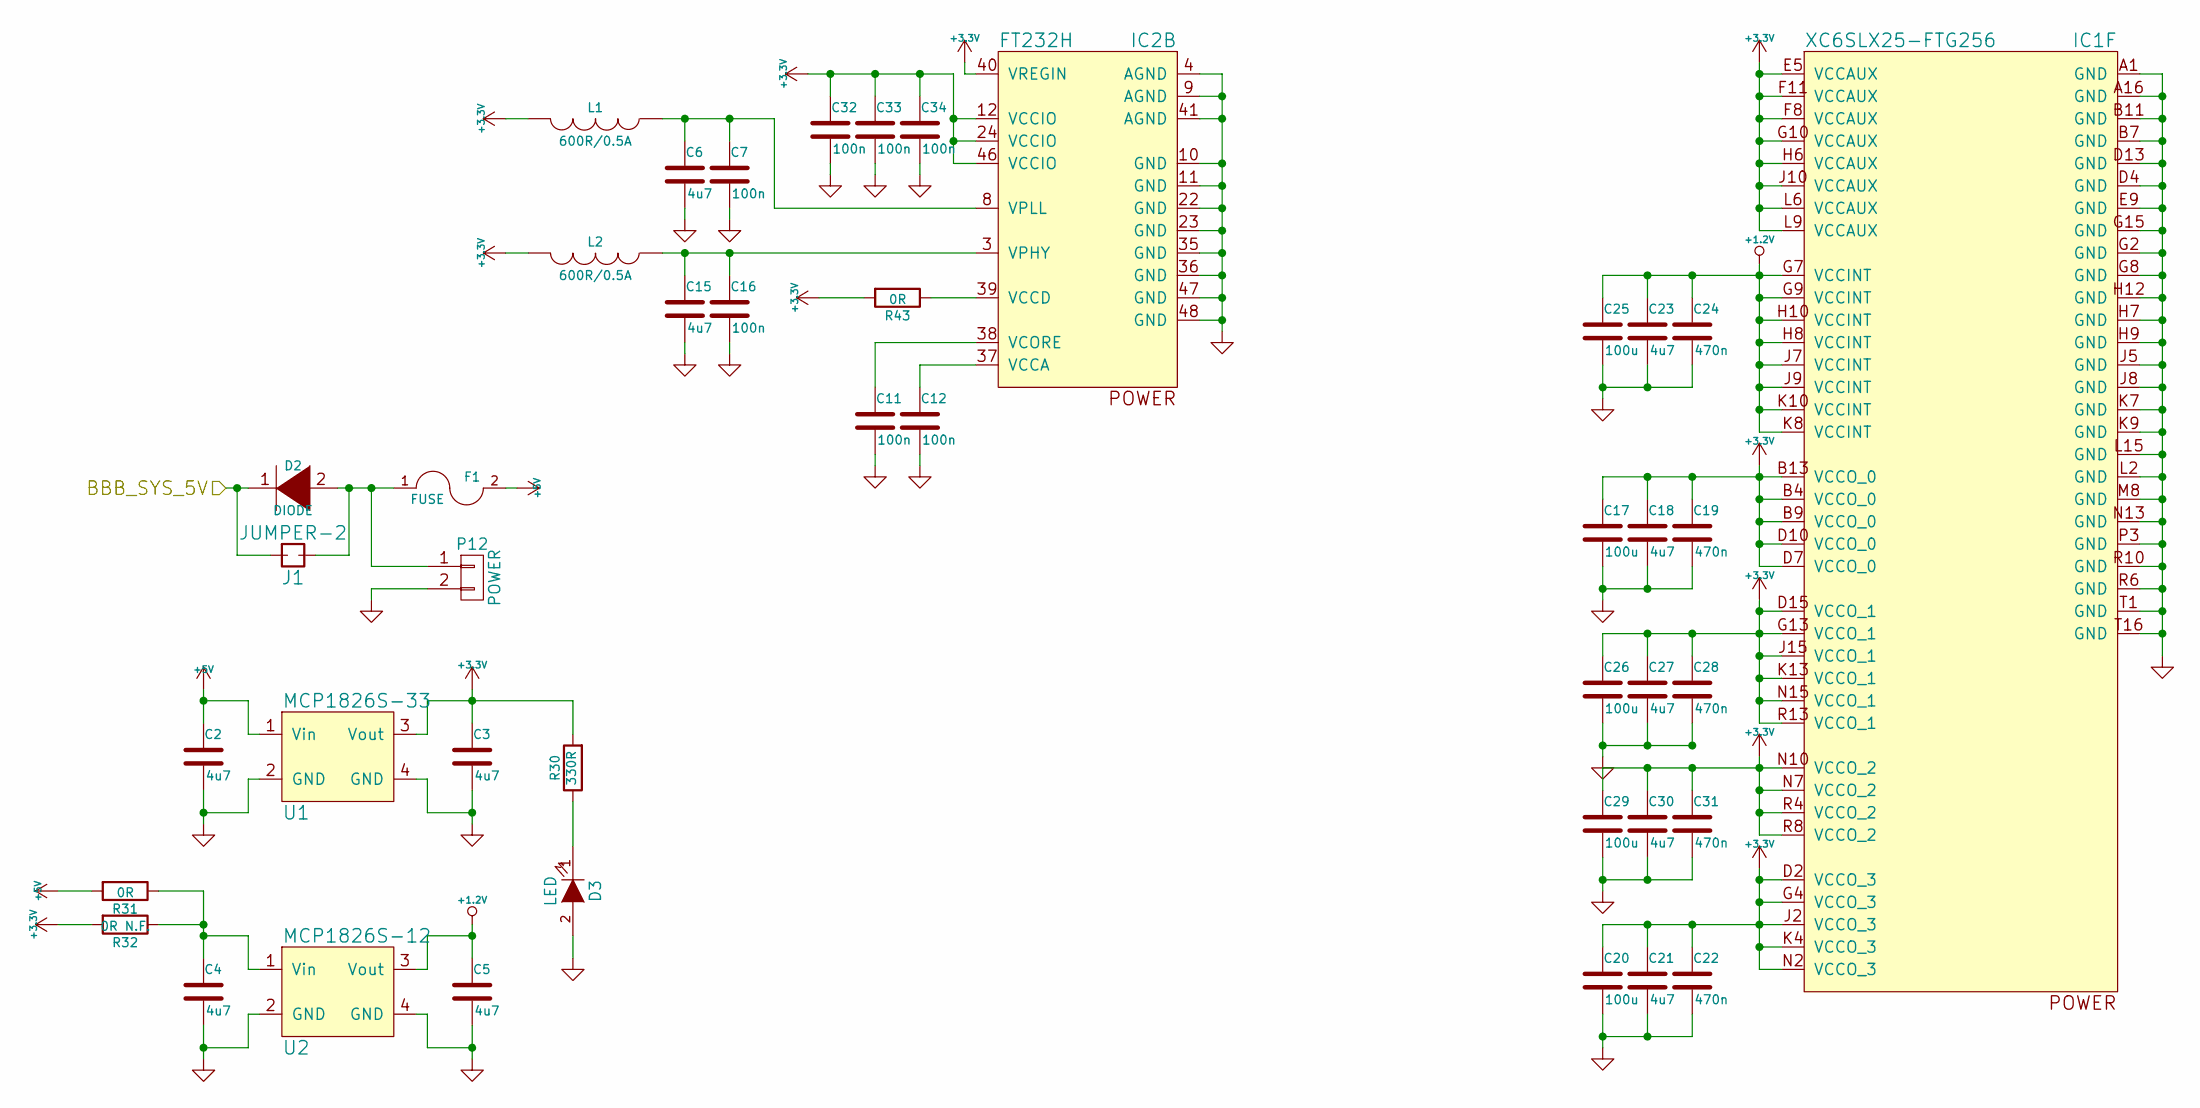
[picture p14: schematic power.sch]

Parts:
C2, C3, C4, C5, C6, C15, C18, C21, C23, C27, C30: 4u7; C_0603
C7, C11, C12, C16, C32, C33, C34: 100n; C_0603
C17, C20, C25, C26, C29: 100u; C_1206
C19, C22, C24, C28, C31: 470n; C_0603
D2: DIODE; DO-214-AA
D3: LED; LED-0603
F1: FUSE; R_1206
IC1: XC6SLX25-FTG256; BGA-256
IC2: FT232H; LQFP-48_7x7mm_Pitch0.5mm
J1: JUMPER-2; Pin_Header_Straight_1x02
L1, L2: 600R/0.5A; R_0603
P12: POWER; PINHEAD1-2
R30: 330R; R_0603
R31, R43: 0R; R_0603
R32: 0R N.F.; R_0603
U1: MCP1826S-33; 3-DDPAK
U2: MCP1826S-12; 3-DDPAK

Connections:
+1.2V: C5.1, C23.1, C24.1, C25.1, IC1.G7 (VCCINT), IC1.G9 (VCCINT), IC1.H8 (VCCINT), IC1.H10 (VCCINT), IC1.J7 (VCCINT), IC1.J9 (VCCINT), IC1.K8 (VCCINT), IC1.K10 (VCCINT), U2.3 (Vout)
+3V3: C3.1, C17.1, C18.1, C19.1, C20.1, C21.1, C22.1, C26.1, C27.1, C28.1, C29.1, C30.1, C31.1, C32.1, C33.1, C34.1, IC1.B4 (VCCO_0), IC1.B9 (VCCO_0), IC1.B13 (VCCO_0), IC1.D2 (VCCO_3), IC1.D7 (VCCO_0), IC1.D10 (VCCO_0), IC1.D15 (VCCO_1), IC1.E5 (VCCAUX), IC1.F8 (VCCAUX), IC1.F11 (VCCAUX), IC1.G4 (VCCO_3), IC1.G10 (VCCAUX), IC1.G13 (VCCO_1), IC1.H6 (VCCAUX), IC1.J2 (VCCO_3), IC1.J10 (VCCAUX), IC1.J15 (VCCO_1), IC1.K4 (VCCO_3), IC1.K13 (VCCO_1), IC1.L6 (VCCAUX), IC1.L9 (VCCAUX), IC1.N2 (VCCO_3), IC1.N7 (VCCO_2), IC1.N10 (VCCO_2), IC1.N15 (VCCO_1), IC1.R4 (VCCO_2), IC1.R8 (VCCO_2), IC1.R13 (VCCO_1), IC2.12 (VCCIO), IC2.24 (VCCIO), IC2.40 (VREGIN), IC2.46 (VCCIO), L1.2, L2.2, R30.2, R32.2, R43.2, U1.3 (Vout); also elsewhere on the board
+5V: C2.1, F1.2, R31.2, U1.1 (Vin); also elsewhere on the board
/BeagleBoneBlack/BBB_SYS_5V: D2.1 (K), J1.1; also elsewhere on the board
GND: C2.2, C3.2, C4.2, C5.2, C6.2, C7.2, C11.2, C12.2, C15.2, C16.2, C17.2, C18.2, C19.2, C20.2, C21.2, C22.2, C23.2, C24.2, C25.2, C26.2, C27.2, C28.2, C29.2, C30.2, C31.2, C32.2, C33.2, C34.2, D3.2 (A), IC1.A1 (GND), IC1.A16 (GND), IC1.B7 (GND), IC1.B11 (GND), IC1.D4 (GND), IC1.D13 (GND), IC1.E9 (GND), IC1.G2 (GND), IC1.G8 (GND), IC1.G15 (GND), IC1.H7 (GND), IC1.H9 (GND), IC1.H12 (GND), IC1.J5 (GND), IC1.J8 (GND), IC1.K7 (GND), IC1.K9 (GND), IC1.L2 (GND), IC1.L15 (GND), IC1.M8 (GND), IC1.N13 (GND), IC1.P3 (GND), IC1.R6 (GND), IC1.R10 (GND), IC1.T1 (GND), IC1.T16 (GND), IC2.4 (AGND), IC2.9 (AGND), IC2.10 (GND), IC2.11 (GND), IC2.22 (GND), IC2.23 (GND), IC2.35 (GND), IC2.36 (GND), IC2.41 (AGND), IC2.47 (GND), IC2.48 (GND), P12.2, U1.2 (GND), U1.4 (GND), U2.2 (GND), U2.4 (GND); also elsewhere on the board
unnamed: C4.1, R31.1, R32.1, U2.1 (Vin)
unnamed: C6.1, C7.1, IC2.8 (VPLL), L1.1
unnamed: C11.1, IC2.38 (VCORE)
unnamed: C12.1, IC2.37 (VCCA)
unnamed: C15.1, C16.1, IC2.3 (VPHY), L2.1
unnamed: D2.2 (A), F1.1, J1.2, P12.1
unnamed: D3.1 (K), R30.1
unnamed: IC2.39 (VCCD), R43.1

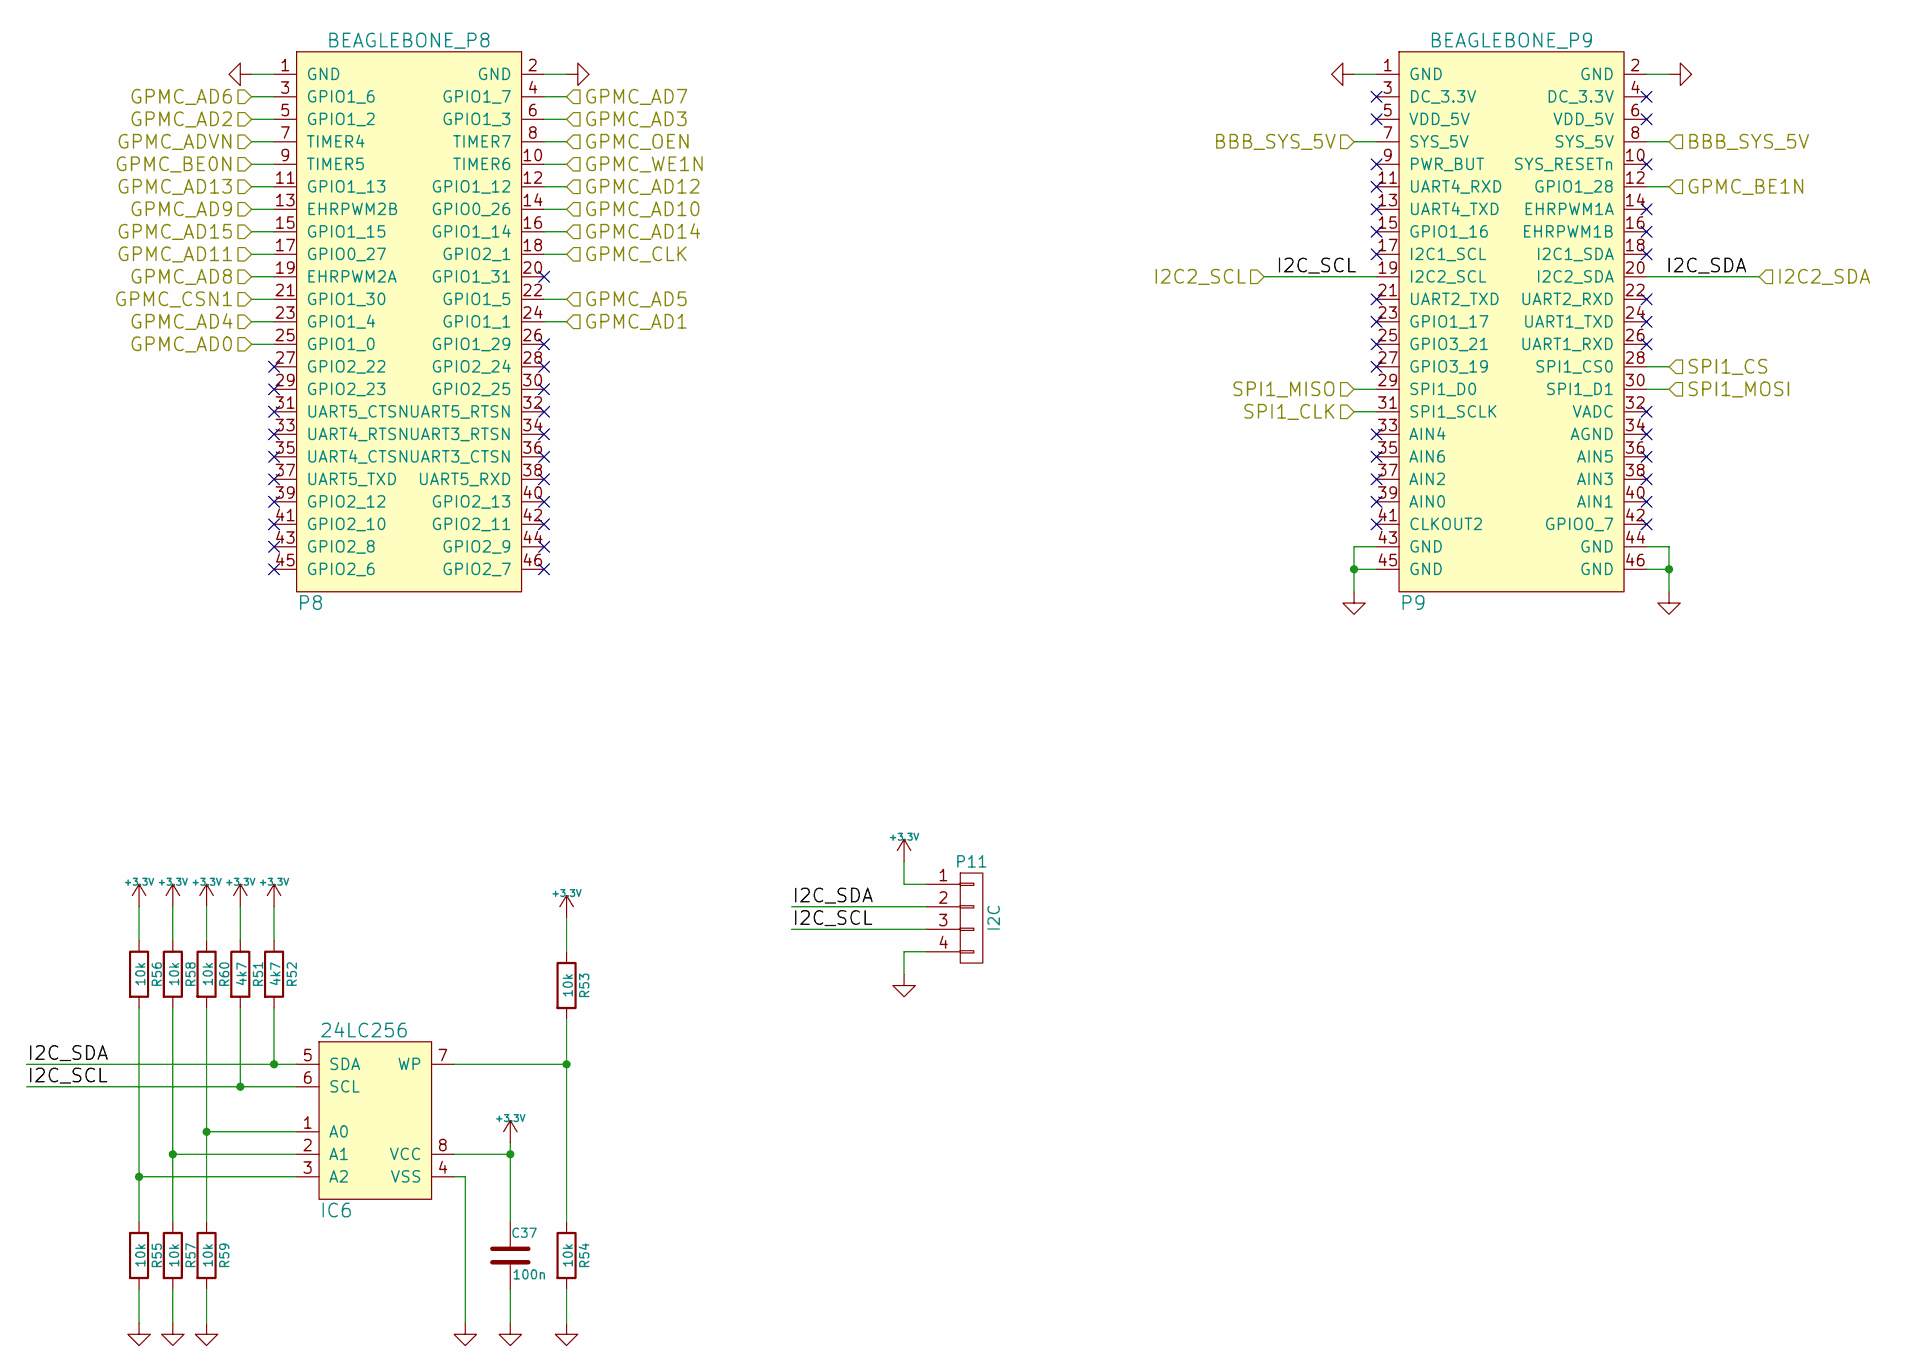
[picture p15: schematic beagleboneblack.sch]

Parts:
C37: 100n; C_0603
IC6: 24LC256; SOIC-8-N
P8: BEAGLEBONE_P8; PIN_HEADER_SMD_2x23
P9: BEAGLEBONE_P9; PIN_HEADER_SMD_2x23
P11: I2C; Pin_Header_Straight_1x04
R51, R52: 4k7; R_0603
R53, R54, R55, R56, R57, R58, R59, R60: 10k; R_0603

Connections:
+3V3: C37.1, IC6.8 (VCC), P11.1, R51.1, R52.1, R53.1, R56.1, R58.1, R60.1; also elsewhere on the board
/BeagleBoneBlack/BBB_SYS_5V: P9.7 (SYS_5V), P9.8 (SYS_5V); also elsewhere on the board
/BeagleBoneBlack/GPMC_AD0: P8.25 (GPIO1_0); also elsewhere on the board
/BeagleBoneBlack/GPMC_AD1: P8.24 (GPIO1_1); also elsewhere on the board
/BeagleBoneBlack/GPMC_AD2: P8.5 (GPIO1_2); also elsewhere on the board
/BeagleBoneBlack/GPMC_AD3: P8.6 (GPIO1_3); also elsewhere on the board
/BeagleBoneBlack/GPMC_AD4: P8.23 (GPIO1_4); also elsewhere on the board
/BeagleBoneBlack/GPMC_AD5: P8.22 (GPIO1_5); also elsewhere on the board
/BeagleBoneBlack/GPMC_AD6: P8.3 (GPIO1_6); also elsewhere on the board
/BeagleBoneBlack/GPMC_AD7: P8.4 (GPIO1_7); also elsewhere on the board
/BeagleBoneBlack/GPMC_AD8: P8.19 (EHRPWM2A); also elsewhere on the board
/BeagleBoneBlack/GPMC_AD9: P8.13 (EHRPWM2B); also elsewhere on the board
/BeagleBoneBlack/GPMC_AD10: P8.14 (GPIO0_26); also elsewhere on the board
/BeagleBoneBlack/GPMC_AD11: P8.17 (GPIO0_27); also elsewhere on the board
/BeagleBoneBlack/GPMC_AD12: P8.12 (GPIO1_12); also elsewhere on the board
/BeagleBoneBlack/GPMC_AD13: P8.11 (GPIO1_13); also elsewhere on the board
/BeagleBoneBlack/GPMC_AD14: P8.16 (GPIO1_14); also elsewhere on the board
/BeagleBoneBlack/GPMC_AD15: P8.15 (GPIO1_15); also elsewhere on the board
/BeagleBoneBlack/GPMC_ADVN: P8.7 (TIMER4); also elsewhere on the board
/BeagleBoneBlack/GPMC_BE0N: P8.9 (TIMER5); also elsewhere on the board
/BeagleBoneBlack/GPMC_BE1N: P9.12 (GPIO1_28); also elsewhere on the board
/BeagleBoneBlack/GPMC_CLK: P8.18 (GPIO2_1); also elsewhere on the board
/BeagleBoneBlack/GPMC_CSN1: P8.21 (GPIO1_30); also elsewhere on the board
/BeagleBoneBlack/GPMC_OEN: P8.8 (TIMER7); also elsewhere on the board
/BeagleBoneBlack/GPMC_WE1N: P8.10 (TIMER6); also elsewhere on the board
/BeagleBoneBlack/I2C2_SCL: IC6.6 (SCL), P9.19 (I2C2_SCL), P11.3, R51.2; also elsewhere on the board
/BeagleBoneBlack/I2C2_SDA: IC6.5 (SDA), P9.20 (I2C2_SDA), P11.2, R52.2; also elsewhere on the board
/BeagleBoneBlack/SPI1_CS: P9.28 (SPI1_CS0)
/FPGA/FPGA_CLK: P9.31 (SPI1_SCLK); also elsewhere on the board
/FPGA/FPGA_MISO: P9.29 (SPI1_D0); also elsewhere on the board
/FPGA/FPGA_MOSI: P9.30 (SPI1_D1); also elsewhere on the board
GND: C37.2, IC6.4 (VSS), P8.1 (GND), P8.2 (GND), P9.1 (GND), P9.2 (GND), P9.43 (GND), P9.44 (GND), P9.45 (GND), P9.46 (GND), P11.4, R54.2, R55.2, R57.2, R59.2; also elsewhere on the board
unnamed: IC6.1 (A0), R59.1, R60.2
unnamed: IC6.2 (A1), R57.1, R58.2
unnamed: IC6.3 (A2), R55.1, R56.2
unnamed: IC6.7 (WP), R53.2, R54.1
