twam/led-display-hardware/Rev2.0/Rev2.0.kicad_pcb

## KiCad design Rev2.0/Rev2.0.kicad_pcb (continued)

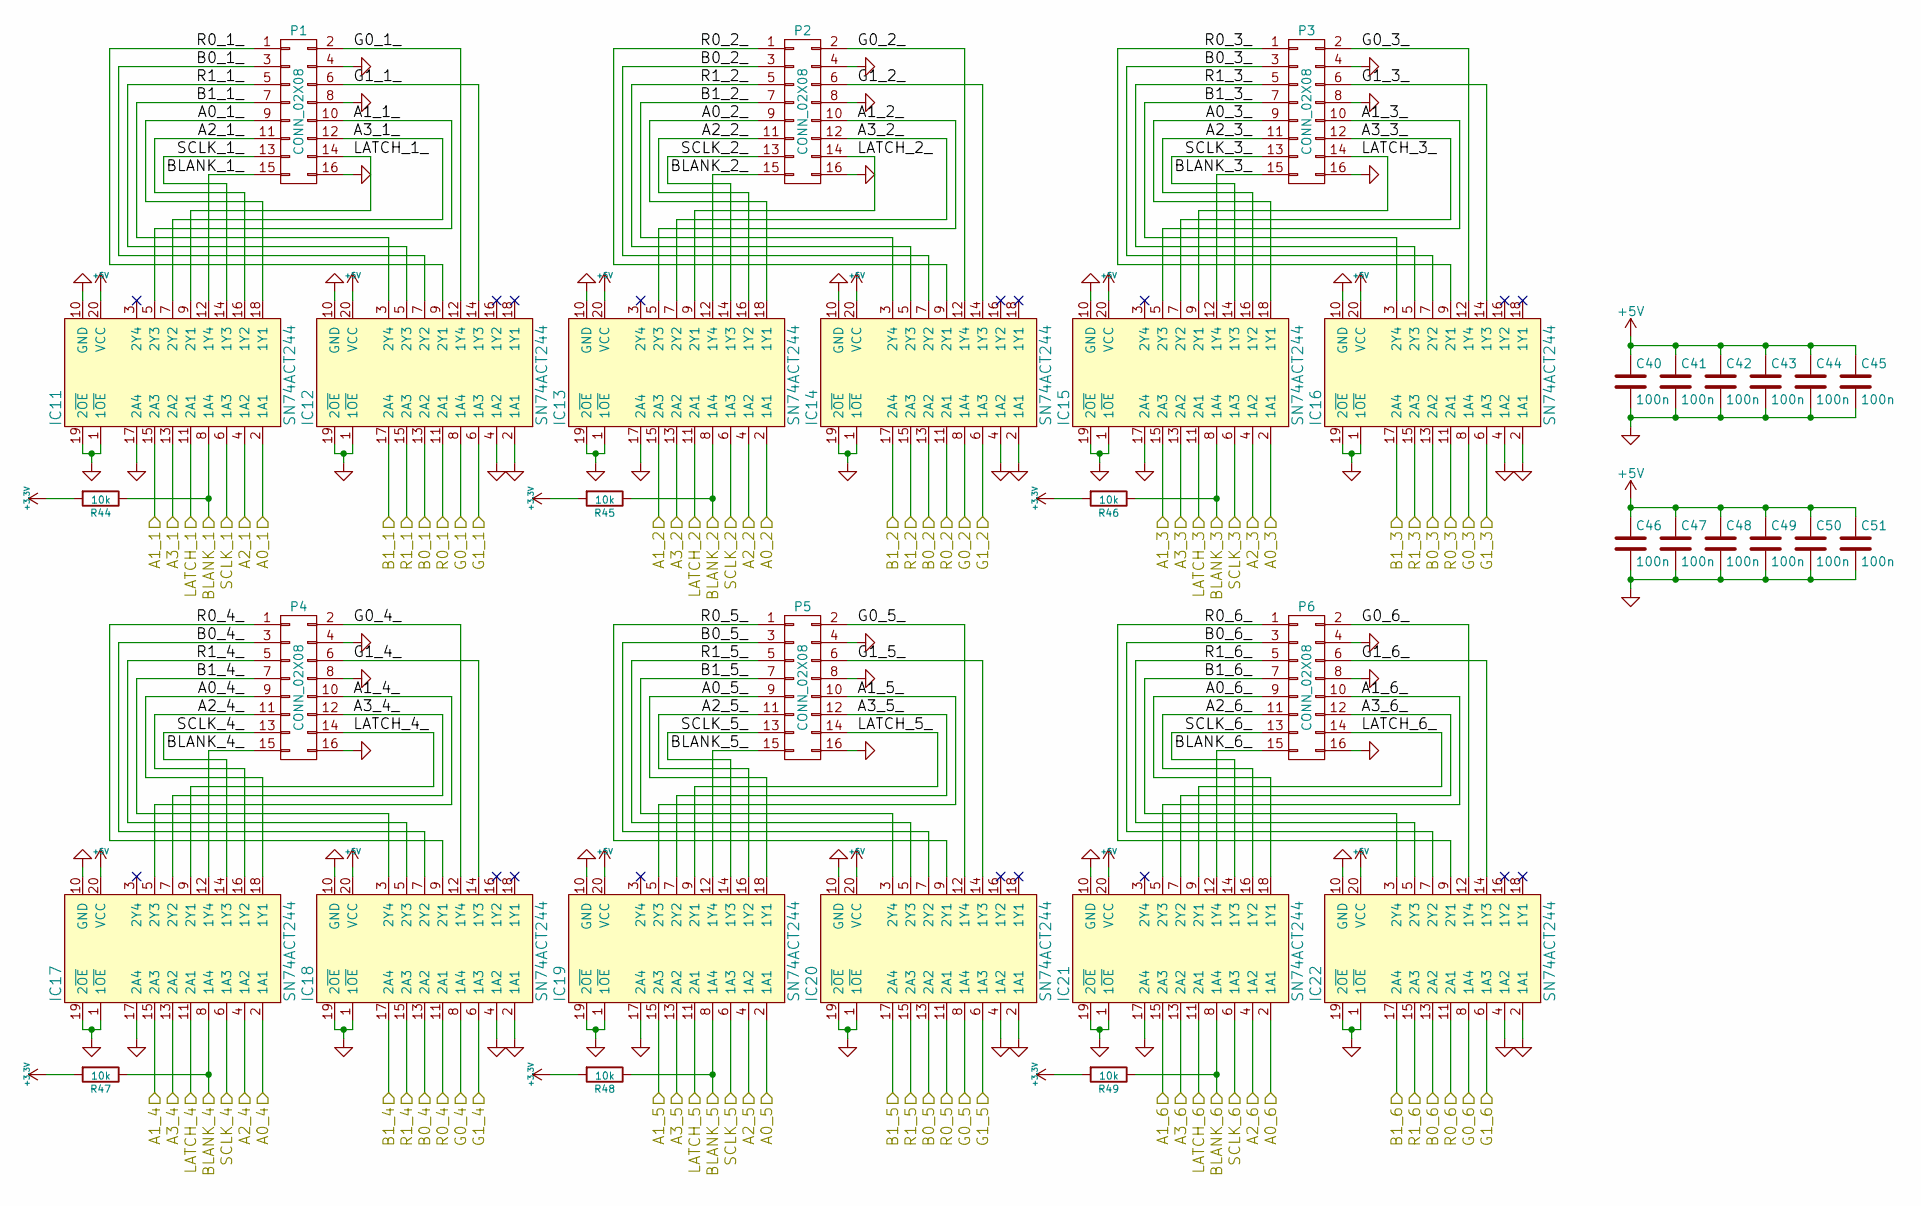
[picture p16: schematic outputs.sch]

Parts:
C40, C41, C42, C43, C44, C45, C46, C47, C48, C49, C50, C51: 100n; C_0603
IC11, IC12, IC13, IC14, IC15, IC16, IC17, IC18, IC19, IC20, IC21, IC22: SN74ACT244; TSSOP-20_4.4x6.5mm_Pitch0.65mm
P1, P2, P3, P4, P5, P6: CONN_02X08; VASCH8x2
R44, R45, R46, R47, R48, R49: 10k; R_0603

Connections:
+3V3: R44.2, R45.2, R46.2, R47.2, R48.2, R49.2; also elsewhere on the board
+5V: C40.1, C41.1, C42.1, C43.1, C44.1, C45.1, C46.1, C47.1, C48.1, C49.1, C50.1, C51.1, IC11.20 (VCC), IC12.20 (VCC), IC13.20 (VCC), IC14.20 (VCC), IC15.20 (VCC), IC16.20 (VCC), IC17.20 (VCC), IC18.20 (VCC), IC19.20 (VCC), IC20.20 (VCC), IC21.20 (VCC), IC22.20 (VCC); also elsewhere on the board
/FPGA/A0_1: IC11.2 (1A1); also elsewhere on the board
/FPGA/A0_2: IC13.2 (1A1); also elsewhere on the board
/FPGA/A0_3: IC15.2 (1A1); also elsewhere on the board
/FPGA/A0_4: IC17.2 (1A1); also elsewhere on the board
/FPGA/A0_5: IC19.2 (1A1); also elsewhere on the board
/FPGA/A0_6: IC21.2 (1A1); also elsewhere on the board
/FPGA/A1_1: IC11.15 (2A3); also elsewhere on the board
/FPGA/A1_2: IC13.15 (2A3); also elsewhere on the board
/FPGA/A1_3: IC15.15 (2A3); also elsewhere on the board
/FPGA/A1_4: IC17.15 (2A3); also elsewhere on the board
/FPGA/A1_5: IC19.15 (2A3); also elsewhere on the board
/FPGA/A1_6: IC21.15 (2A3); also elsewhere on the board
/FPGA/A2_1: IC11.4 (1A2); also elsewhere on the board
/FPGA/A2_2: IC13.4 (1A2); also elsewhere on the board
/FPGA/A2_3: IC15.4 (1A2); also elsewhere on the board
/FPGA/A2_4: IC17.4 (1A2); also elsewhere on the board
/FPGA/A2_5: IC19.4 (1A2); also elsewhere on the board
/FPGA/A2_6: IC21.4 (1A2); also elsewhere on the board
/FPGA/A3_1: IC11.13 (2A2); also elsewhere on the board
/FPGA/A3_2: IC13.13 (2A2); also elsewhere on the board
/FPGA/A3_3: IC15.13 (2A2); also elsewhere on the board
/FPGA/A3_4: IC17.13 (2A2); also elsewhere on the board
/FPGA/A3_5: IC19.13 (2A2); also elsewhere on the board
/FPGA/A3_6: IC21.13 (2A2); also elsewhere on the board
/FPGA/B0_1: IC12.13 (2A2); also elsewhere on the board
/FPGA/B0_2: IC14.13 (2A2); also elsewhere on the board
/FPGA/B0_3: IC16.13 (2A2); also elsewhere on the board
/FPGA/B0_4: IC18.13 (2A2); also elsewhere on the board
/FPGA/B0_5: IC20.13 (2A2); also elsewhere on the board
/FPGA/B0_6: IC22.13 (2A2); also elsewhere on the board
/FPGA/B1_1: IC12.17 (2A4); also elsewhere on the board
/FPGA/B1_2: IC14.17 (2A4); also elsewhere on the board
/FPGA/B1_3: IC16.17 (2A4); also elsewhere on the board
/FPGA/B1_4: IC18.17 (2A4); also elsewhere on the board
/FPGA/B1_5: IC20.17 (2A4); also elsewhere on the board
/FPGA/B1_6: IC22.17 (2A4); also elsewhere on the board
/FPGA/BLANK_1: IC11.8 (1A4), R44.1; also elsewhere on the board
/FPGA/BLANK_2: IC13.8 (1A4), R45.1; also elsewhere on the board
/FPGA/BLANK_3: IC15.8 (1A4), R46.1; also elsewhere on the board
/FPGA/BLANK_4: IC17.8 (1A4), R47.1; also elsewhere on the board
/FPGA/BLANK_5: IC19.8 (1A4), R48.1; also elsewhere on the board
/FPGA/BLANK_6: IC21.8 (1A4), R49.1; also elsewhere on the board
/FPGA/G0_1: IC12.8 (1A4); also elsewhere on the board
/FPGA/G0_2: IC14.8 (1A4); also elsewhere on the board
/FPGA/G0_3: IC16.8 (1A4); also elsewhere on the board
/FPGA/G0_4: IC18.8 (1A4); also elsewhere on the board
/FPGA/G0_5: IC20.8 (1A4); also elsewhere on the board
/FPGA/G0_6: IC22.8 (1A4); also elsewhere on the board
/FPGA/G1_1: IC12.6 (1A3); also elsewhere on the board
/FPGA/G1_2: IC14.6 (1A3); also elsewhere on the board
/FPGA/G1_3: IC16.6 (1A3); also elsewhere on the board
/FPGA/G1_4: IC18.6 (1A3); also elsewhere on the board
/FPGA/G1_5: IC20.6 (1A3); also elsewhere on the board
/FPGA/G1_6: IC22.6 (1A3); also elsewhere on the board
/FPGA/LATCH_1: IC11.11 (2A1); also elsewhere on the board
/FPGA/LATCH_2: IC13.11 (2A1); also elsewhere on the board
/FPGA/LATCH_3: IC15.11 (2A1); also elsewhere on the board
/FPGA/LATCH_4: IC17.11 (2A1); also elsewhere on the board
/FPGA/LATCH_5: IC19.11 (2A1); also elsewhere on the board
/FPGA/LATCH_6: IC21.11 (2A1); also elsewhere on the board
/FPGA/R0_1: IC12.11 (2A1); also elsewhere on the board
/FPGA/R0_2: IC14.11 (2A1); also elsewhere on the board
/FPGA/R0_3: IC16.11 (2A1); also elsewhere on the board
/FPGA/R0_4: IC18.11 (2A1); also elsewhere on the board
/FPGA/R0_5: IC20.11 (2A1); also elsewhere on the board
/FPGA/R0_6: IC22.11 (2A1); also elsewhere on the board
/FPGA/R1_1: IC12.15 (2A3); also elsewhere on the board
/FPGA/R1_2: IC14.15 (2A3); also elsewhere on the board
/FPGA/R1_3: IC16.15 (2A3); also elsewhere on the board
/FPGA/R1_4: IC18.15 (2A3); also elsewhere on the board
/FPGA/R1_5: IC20.15 (2A3); also elsewhere on the board
/FPGA/R1_6: IC22.15 (2A3); also elsewhere on the board
/FPGA/SCLK_1: IC11.6 (1A3); also elsewhere on the board
/FPGA/SCLK_2: IC13.6 (1A3); also elsewhere on the board
/FPGA/SCLK_3: IC15.6 (1A3); also elsewhere on the board
/FPGA/SCLK_4: IC17.6 (1A3); also elsewhere on the board
/FPGA/SCLK_5: IC19.6 (1A3); also elsewhere on the board
/FPGA/SCLK_6: IC21.6 (1A3); also elsewhere on the board
/Outputs/A0_1_: IC11.18 (1Y1), P1.9
/Outputs/A0_2_: IC13.18 (1Y1), P2.9
/Outputs/A0_3_: IC15.18 (1Y1), P3.9
/Outputs/A0_4_: IC17.18 (1Y1), P4.9
/Outputs/A0_5_: IC19.18 (1Y1), P5.9
/Outputs/A0_6_: IC21.18 (1Y1), P6.9
/Outputs/A1_1_: IC11.5 (2Y3), P1.10
/Outputs/A1_2_: IC13.5 (2Y3), P2.10
/Outputs/A1_3_: IC15.5 (2Y3), P3.10
/Outputs/A1_4_: IC17.5 (2Y3), P4.10
/Outputs/A1_5_: IC19.5 (2Y3), P5.10
/Outputs/A1_6_: IC21.5 (2Y3), P6.10
/Outputs/A2_1_: IC11.16 (1Y2), P1.11
/Outputs/A2_2_: IC13.16 (1Y2), P2.11
/Outputs/A2_3_: IC15.16 (1Y2), P3.11
/Outputs/A2_4_: IC17.16 (1Y2), P4.11
/Outputs/A2_5_: IC19.16 (1Y2), P5.11
/Outputs/A2_6_: IC21.16 (1Y2), P6.11
/Outputs/A3_1_: IC11.7 (2Y2), P1.12
/Outputs/A3_2_: IC13.7 (2Y2), P2.12
/Outputs/A3_3_: IC15.7 (2Y2), P3.12
/Outputs/A3_4_: IC17.7 (2Y2), P4.12
/Outputs/A3_5_: IC19.7 (2Y2), P5.12
/Outputs/A3_6_: IC21.7 (2Y2), P6.12
/Outputs/B0_1_: IC12.7 (2Y2), P1.3
/Outputs/B0_2_: IC14.7 (2Y2), P2.3
/Outputs/B0_3_: IC16.7 (2Y2), P3.3
/Outputs/B0_4_: IC18.7 (2Y2), P4.3
/Outputs/B0_5_: IC20.7 (2Y2), P5.3
/Outputs/B0_6_: IC22.7 (2Y2), P6.3
/Outputs/B1_1_: IC12.3 (2Y4), P1.7
/Outputs/B1_2_: IC14.3 (2Y4), P2.7
/Outputs/B1_3_: IC16.3 (2Y4), P3.7
/Outputs/B1_4_: IC18.3 (2Y4), P4.7
/Outputs/B1_5_: IC20.3 (2Y4), P5.7
/Outputs/B1_6_: IC22.3 (2Y4), P6.7
/Outputs/BLANK_1_: IC11.12 (1Y4), P1.15
/Outputs/BLANK_2_: IC13.12 (1Y4), P2.15
/Outputs/BLANK_3_: IC15.12 (1Y4), P3.15
/Outputs/BLANK_4_: IC17.12 (1Y4), P4.15
/Outputs/BLANK_5_: IC19.12 (1Y4), P5.15
/Outputs/BLANK_6_: IC21.12 (1Y4), P6.15
/Outputs/G0_1_: IC12.12 (1Y4), P1.2
/Outputs/G0_2_: IC14.12 (1Y4), P2.2
/Outputs/G0_3_: IC16.12 (1Y4), P3.2
/Outputs/G0_4_: IC18.12 (1Y4), P4.2
/Outputs/G0_5_: IC20.12 (1Y4), P5.2
/Outputs/G0_6_: IC22.12 (1Y4), P6.2
/Outputs/G1_1_: IC12.14 (1Y3), P1.6
/Outputs/G1_2_: IC14.14 (1Y3), P2.6
/Outputs/G1_3_: IC16.14 (1Y3), P3.6
/Outputs/G1_4_: IC18.14 (1Y3), P4.6
/Outputs/G1_5_: IC20.14 (1Y3), P5.6
/Outputs/G1_6_: IC22.14 (1Y3), P6.6
/Outputs/LATCH_1_: IC11.9 (2Y1), P1.14
/Outputs/LATCH_2_: IC13.9 (2Y1), P2.14
/Outputs/LATCH_3_: IC15.9 (2Y1), P3.14
/Outputs/LATCH_4_: IC17.9 (2Y1), P4.14
/Outputs/LATCH_5_: IC19.9 (2Y1), P5.14
/Outputs/LATCH_6_: IC21.9 (2Y1), P6.14
/Outputs/R0_1_: IC12.9 (2Y1), P1.1
/Outputs/R0_2_: IC14.9 (2Y1), P2.1
/Outputs/R0_3_: IC16.9 (2Y1), P3.1
/Outputs/R0_4_: IC18.9 (2Y1), P4.1
/Outputs/R0_5_: IC20.9 (2Y1), P5.1
/Outputs/R0_6_: IC22.9 (2Y1), P6.1
/Outputs/R1_1_: IC12.5 (2Y3), P1.5
/Outputs/R1_2_: IC14.5 (2Y3), P2.5
/Outputs/R1_3_: IC16.5 (2Y3), P3.5
/Outputs/R1_4_: IC18.5 (2Y3), P4.5
/Outputs/R1_5_: IC20.5 (2Y3), P5.5
/Outputs/R1_6_: IC22.5 (2Y3), P6.5
/Outputs/SCLK_1_: IC11.14 (1Y3), P1.13
/Outputs/SCLK_2_: IC13.14 (1Y3), P2.13
/Outputs/SCLK_3_: IC15.14 (1Y3), P3.13
/Outputs/SCLK_4_: IC17.14 (1Y3), P4.13
/Outputs/SCLK_5_: IC19.14 (1Y3), P5.13
/Outputs/SCLK_6_: IC21.14 (1Y3), P6.13
GND: C40.2, C41.2, C42.2, C43.2, C44.2, C45.2, C46.2, C47.2, C48.2, C49.2, C50.2, C51.2, IC11.1 (1~OE), IC11.10 (GND), IC11.17 (2A4), IC11.19 (2~OE), IC12.1 (1~OE), IC12.2 (1A1), IC12.4 (1A2), IC12.10 (GND), IC12.19 (2~OE), IC13.1 (1~OE), IC13.10 (GND), IC13.17 (2A4), IC13.19 (2~OE), IC14.1 (1~OE), IC14.2 (1A1), IC14.4 (1A2), IC14.10 (GND), IC14.19 (2~OE), IC15.1 (1~OE), IC15.10 (GND), IC15.17 (2A4), IC15.19 (2~OE), IC16.1 (1~OE), IC16.2 (1A1), IC16.4 (1A2), IC16.10 (GND), IC16.19 (2~OE), IC17.1 (1~OE), IC17.10 (GND), IC17.17 (2A4), IC17.19 (2~OE), IC18.1 (1~OE), IC18.2 (1A1), IC18.4 (1A2), IC18.10 (GND), IC18.19 (2~OE), IC19.1 (1~OE), IC19.10 (GND), IC19.17 (2A4), IC19.19 (2~OE), IC20.1 (1~OE), IC20.2 (1A1), IC20.4 (1A2), IC20.10 (GND), IC20.19 (2~OE), IC21.1 (1~OE), IC21.10 (GND), IC21.17 (2A4), IC21.19 (2~OE), IC22.1 (1~OE), IC22.2 (1A1), IC22.4 (1A2), IC22.10 (GND), IC22.19 (2~OE), P1.4, P1.8, P1.16, P2.4, P2.8, P2.16, P3.4, P3.8, P3.16, P4.4, P4.8, P4.16, P5.4, P5.8, P5.16, P6.4, P6.8, P6.16; also elsewhere on the board

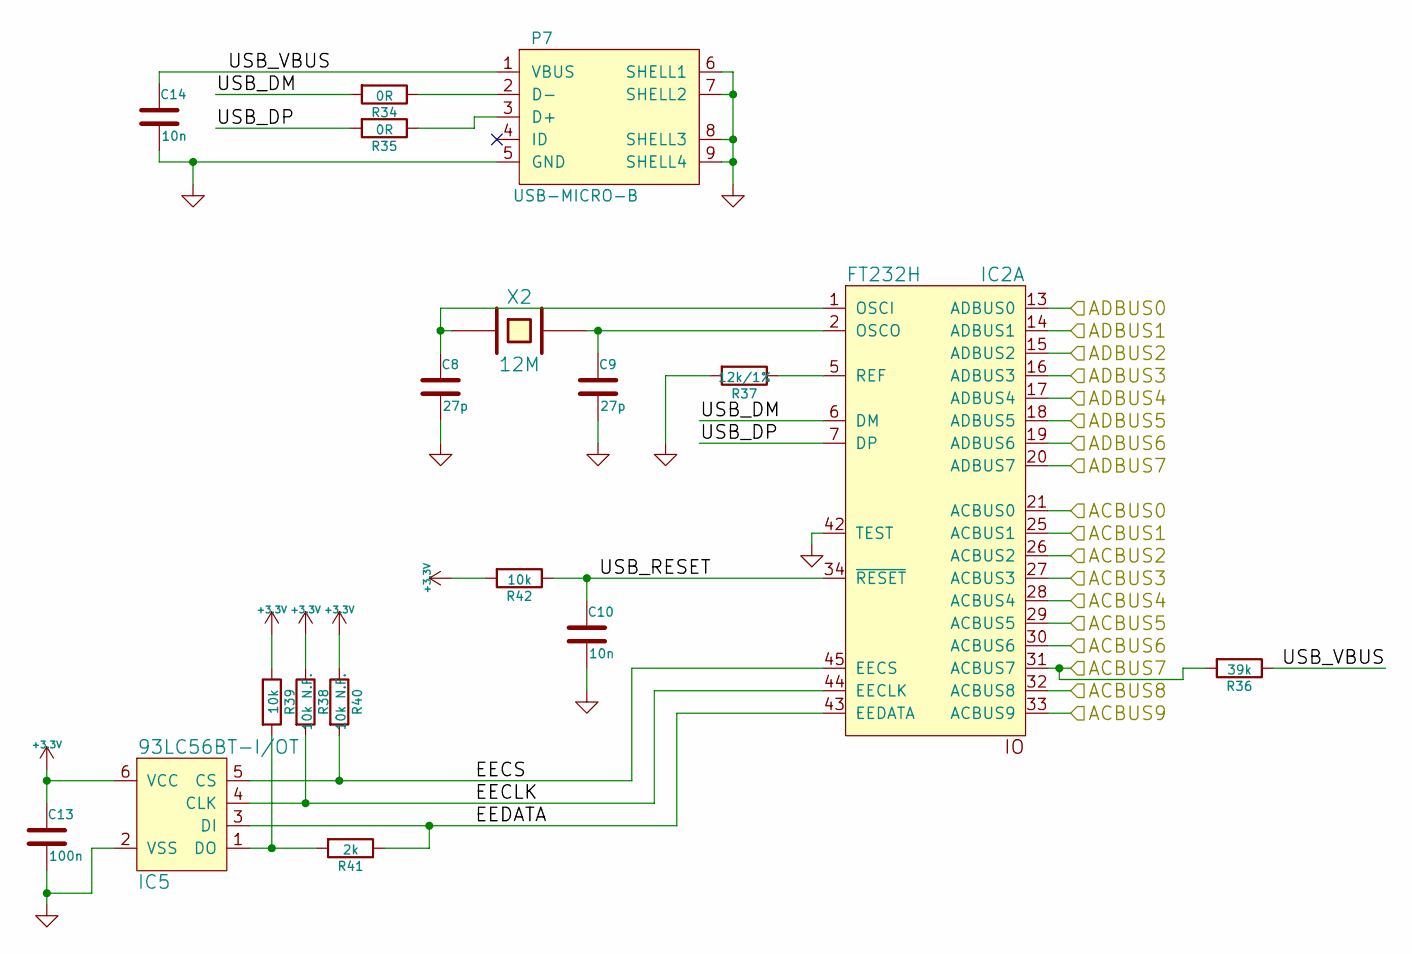
[picture p17: schematic USB.sch]

Parts:
C8, C9: 27p; C_0603
C10, C14: 10n; C_0603
C13: 100n; C_0603
IC2: FT232H; LQFP-48_7x7mm_Pitch0.5mm
IC5: 93LC56BT-I/OT; SOT-23-6
P7: USB-MICRO-B; 47589-0001
R34, R35: 0R; R_0603
R36: 39k; R_0603
R37: 12k/1%; R_0603
R38, R40: 10k N.F.; R_0603
R39, R42: 10k; R_0603
R41: 2k; R_0603
X2: 12M; Crystal_HC49-SD_SMD

Connections:
+3V3: C13.1, IC5.6 (VCC), R38.1, R39.1, R40.1, R42.2; also elsewhere on the board
/FPGA/ACBUS0: IC2.21 (ACBUS0); also elsewhere on the board
/FPGA/ACBUS1: IC2.25 (ACBUS1); also elsewhere on the board
/FPGA/ACBUS2: IC2.26 (ACBUS2); also elsewhere on the board
/FPGA/ACBUS3: IC2.27 (ACBUS3); also elsewhere on the board
/FPGA/ACBUS4: IC2.28 (ACBUS4); also elsewhere on the board
/FPGA/ACBUS5: IC2.29 (ACBUS5); also elsewhere on the board
/FPGA/ACBUS6: IC2.30 (ACBUS6); also elsewhere on the board
/FPGA/ACBUS7: IC2.31 (ACBUS7), R36.2; also elsewhere on the board
/FPGA/ACBUS8: IC2.32 (ACBUS8); also elsewhere on the board
/FPGA/ACBUS9: IC2.33 (ACBUS9); also elsewhere on the board
/FPGA/ADBUS0: IC2.13 (ADBUS0); also elsewhere on the board
/FPGA/ADBUS1: IC2.14 (ADBUS1); also elsewhere on the board
/FPGA/ADBUS2: IC2.15 (ADBUS2); also elsewhere on the board
/FPGA/ADBUS3: IC2.16 (ADBUS3); also elsewhere on the board
/FPGA/ADBUS4: IC2.17 (ADBUS4); also elsewhere on the board
/FPGA/ADBUS5: IC2.18 (ADBUS5); also elsewhere on the board
/FPGA/ADBUS6: IC2.19 (ADBUS6); also elsewhere on the board
/FPGA/ADBUS7: IC2.20 (ADBUS7); also elsewhere on the board
/USB/EECLK: IC2.44 (EECLK), IC5.4 (CLK), R38.2
/USB/EECS: IC2.45 (EECS), IC5.5 (CS), R40.2
/USB/EEDATA: IC2.43 (EEDATA), IC5.3 (DI), R41.1
/USB/USB_DM: IC2.6 (DM), R34.2
/USB/USB_DP: IC2.7 (DP), R35.2
/USB/USB_RESET: C10.1, IC2.34 (~RESET), R42.1
/USB/USB_VBUS: C14.1, P7.1 (VBUS), R36.1
GND: C8.2, C9.2, C10.2, C13.2, C14.2, IC2.42 (TEST), IC5.2 (VSS), P7.5 (GND), P7.6 (SHELL1), P7.7 (SHELL2), P7.8 (SHELL3), P7.9 (SHELL4), R37.2; also elsewhere on the board
unnamed: C8.1, IC2.1 (OSCI), X2.1
unnamed: C9.1, IC2.2 (OSCO), X2.2
unnamed: IC2.5 (REF), R37.1
unnamed: IC5.1 (DO), R39.2, R41.2
unnamed: P7.2 (D-), R34.1
unnamed: P7.3 (D+), R35.1

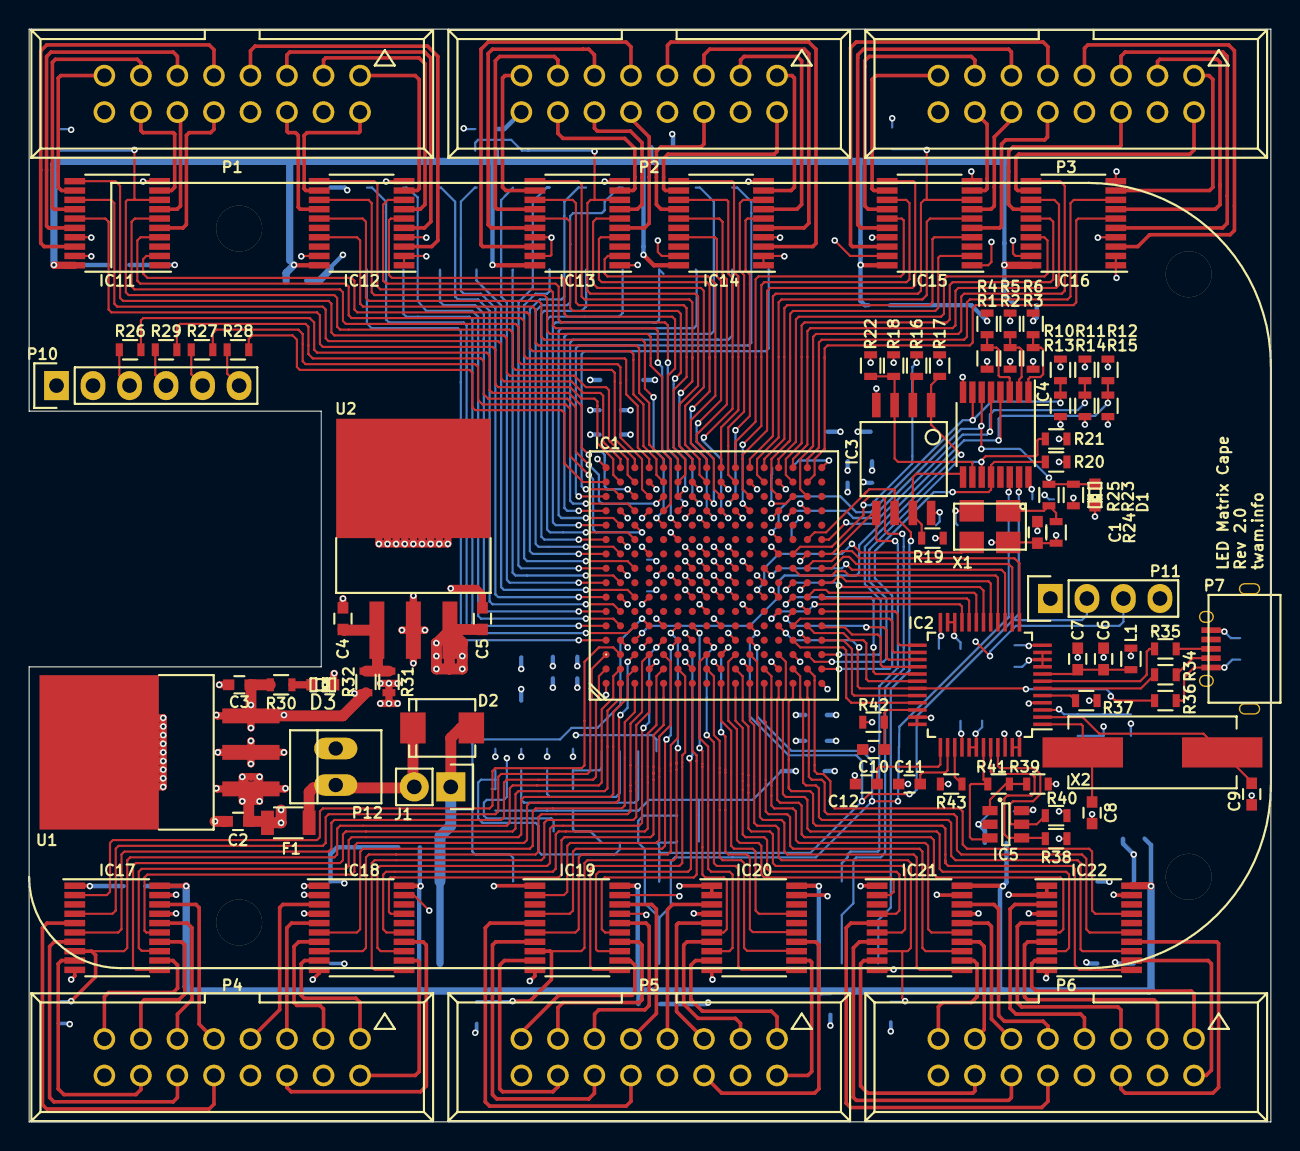
[picture p18: board Rev2.0.kicad_pcb from above]

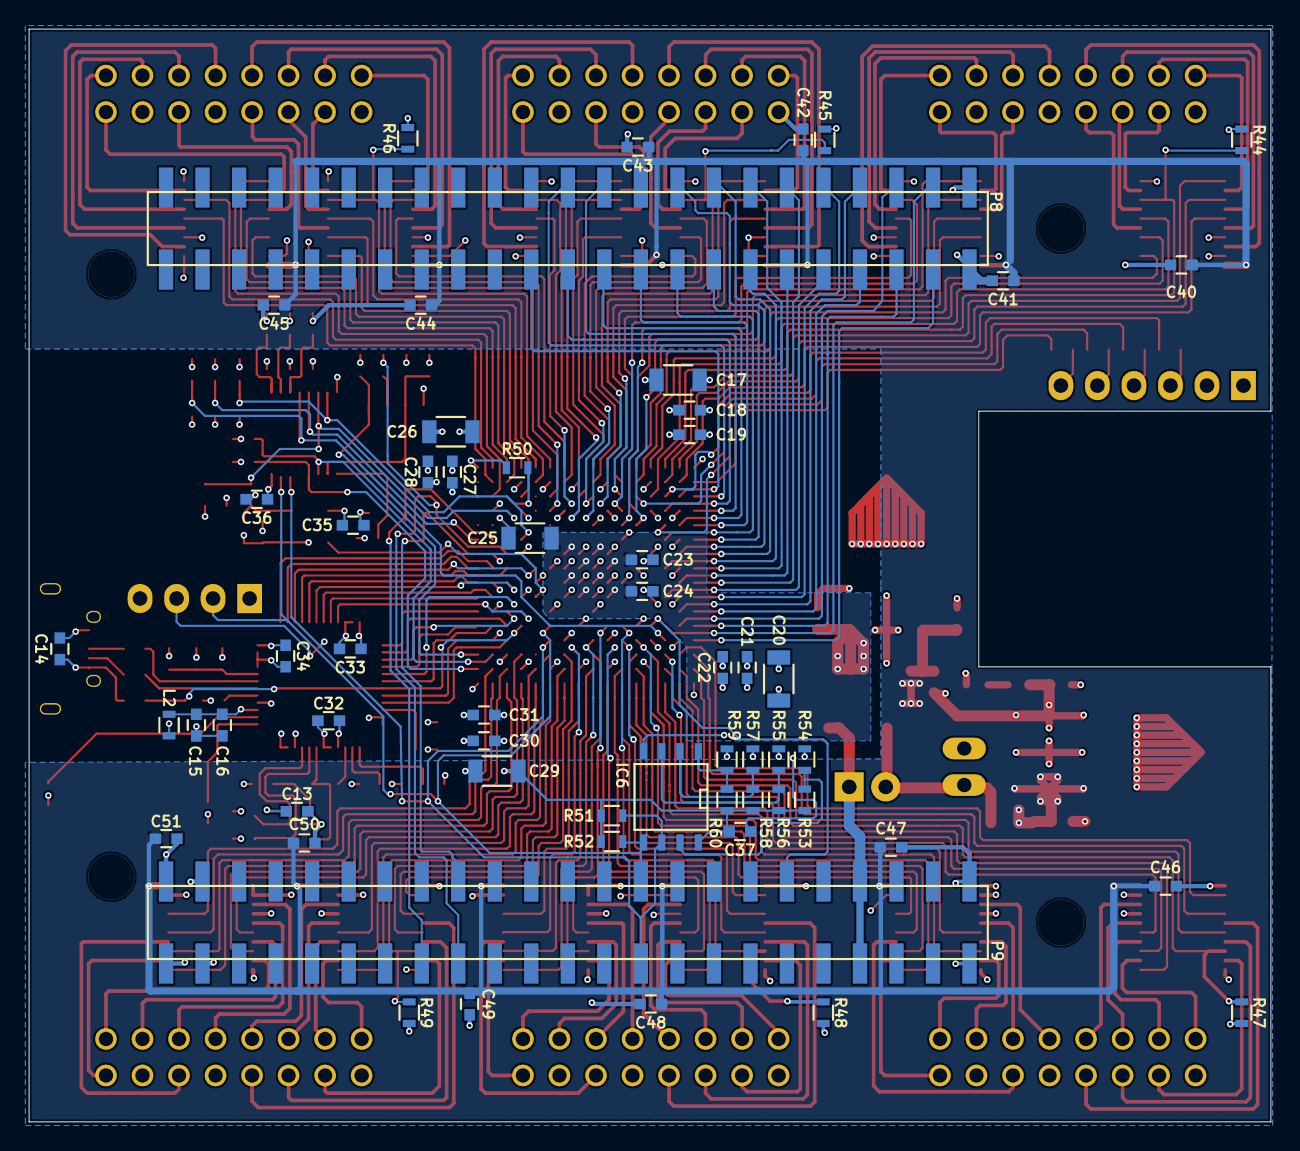
[picture p19: board Rev2.0.kicad_pcb from below]

Board: 4 copper layers, 86.4 x 76.0 mm, 150 parts (58 on the bottom side), 256 nets.

Other parts of the board:
MOUNTING_HOLE_3-2MM_M3, MOUNTING_HOLE_3-2MM_M3#2, MOUNTING_HOLE_3-2MM_M3#3, MOUNTING_HOLE_3-2MM_M3#4: VAL**; MOUNTING_HOLE_3-2MM_M3
