twam/led-display-hardware/Rev1.0/led-matrix-cape.brd

## EAGLE design Rev1.0/led-matrix-cape.brd (2015-06-09, an earlier design)

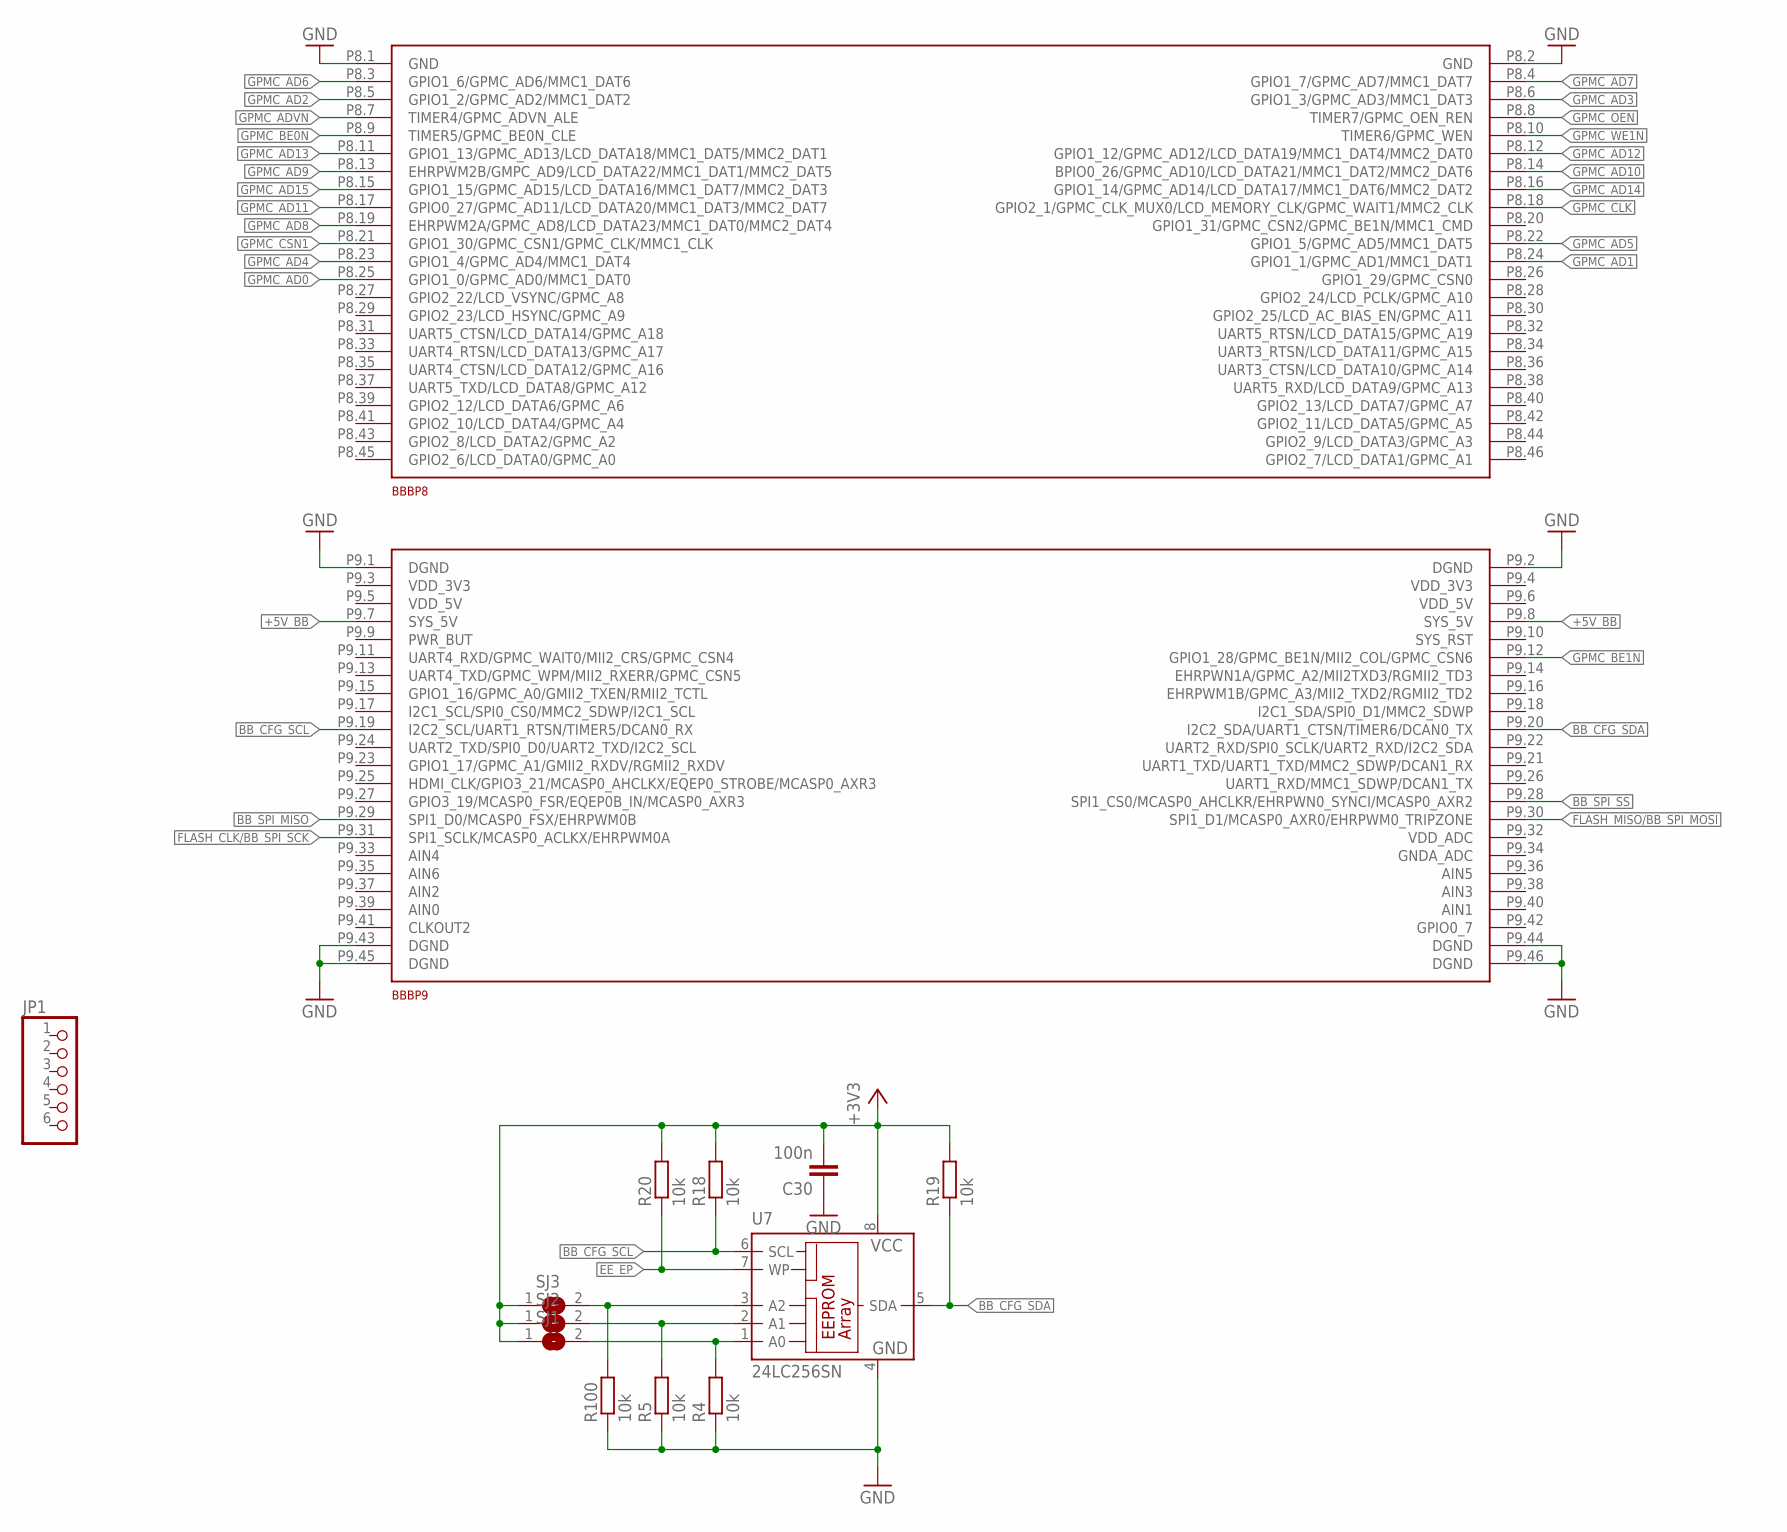
[picture p20: schematic led-matrix-cape.sch, sheet 1]

Parts:
BBB: BEAGLEBONE_CAPE_CONNECTORS; BEAGLEBONE_CAPE
C30: 100n; C0603
JP1: PINHD-1X6; 1X06
R4, R5, R18, R19, R20, R100: 10k; R0603
SJ1, SJ2, SJ3: SJ
U7: 24LC256SN; SO-08

Connections:
+3V3: C30.2, R18.2, R19.2, R20.2, SJ1.1, SJ2.1, SJ3.1, U7.8 (VCC); also elsewhere on the board
+5V_BB: BBB.P9.7 (SYS_5V), BBB.P9.8 (SYS_5V); also elsewhere on the board
ADDR0: R4.2, SJ1.2, U7.1 (A0)
ADDR1: R5.2, SJ2.2, U7.2 (A1)
ADDR2: R100.2, SJ3.2, U7.3 (A2)
BB_CFG_SCL: BBB.P9.19 (I2C2_SCL/UART1_RTSN/TIMER5/DCAN0_RX), R18.1, U7.6 (SCL); also elsewhere on the board
BB_CFG_SDA: BBB.P9.20 (I2C2_SDA/UART1_CTSN/TIMER6/DCAN0_TX), R19.1, U7.5 (SDA); also elsewhere on the board
BB_SPI_MISO: BBB.P9.29 (SPI1_D0/MCASP0_FSX/EHRPWM0B); also elsewhere on the board
BB_SPI_SS: BBB.P9.28 (SPI1_CS0/MCASP0_AHCLKR/EHRPWN0_SYNCI/MC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); also elsewhere on the board
EE_EP: R20.1, U7.7 (WP)
FLASH_CLK/BB_SPI_SCK: BBB.P9.31 (SPI1_SCLK/MCASP0_ACLKX/EHRPWM0A); also elsewhere on the board
FLASH_MISO/BB_SPI_MOSI: BBB.P9.30 (SPI1_D1/MCASP0_AXR0/EHRPWM0_TRIPZONE); also elsewhere on the board
GND: BBB.P8.1 (GND), BBB.P8.2 (GND), BBB.P9.1 (DGND), BBB.P9.2 (DGND), BBB.P9.43 (DGND), BBB.P9.44 (DGND), BBB.P9.45 (DGND), BBB.P9.46 (DGND), C30.1, R4.1, R5.1, R100.1, U7.4 (GND); also elsewhere on the board
GPMC_AD0: BBB.P8.25 (GPIO1_0/GPMC_AD0/MMC1_DAT0); also elsewhere on the board
GPMC_AD1: BBB.P8.24 (GPIO1_1/GPMC_AD1/MMC1_DAT1); also elsewhere on the board
GPMC_AD2: BBB.P8.5 (GPIO1_2/GPMC_AD2/MMC1_DAT2); also elsewhere on the board
GPMC_AD3: BBB.P8.6 (GPIO1_3/GPMC_AD3/MMC1_DAT3); also elsewhere on the board
GPMC_AD4: BBB.P8.23 (GPIO1_4/GPMC_AD4/MMC1_DAT4); also elsewhere on the board
GPMC_AD5: BBB.P8.22 (GPIO1_5/GPMC_AD5/MMC1_DAT5); also elsewhere on the board
GPMC_AD6: BBB.P8.3 (GPIO1_6/GPMC_AD6/MMC1_DAT6); also elsewhere on the board
GPMC_AD7: BBB.P8.4 (GPIO1_7/GPMC_AD7/MMC1_DAT7); also elsewhere on the board
GPMC_AD8: BBB.P8.19 (EHRPWM2A/GPMC_AD8/LCD_DATA23/MMC1_DAT0/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); also elsewhere on the board
GPMC_AD9: BBB.P8.13 (EHRPWM2B/GMPC_AD9/LCD_DATA22/MMC1_DAT1/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); also elsewhere on the board
GPMC_AD10: BBB.P8.14 (BPIO0_26/GPMC_AD10/LCD_DATA21/MMC1_DAT2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); also elsewhere on the board
GPMC_AD11: BBB.P8.17 (GPIO0_27/GPMC_AD11/LCD_DATA20/MMC1_DAT3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); also elsewhere on the board
GPMC_AD12: BBB.P8.12 (GPIO1_12/GPMC_AD12/LCD_DATA19/MMC1_DAT4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); also elsewhere on the board
GPMC_AD13: BBB.P8.11 (GPIO1_13/GPMC_AD13/LCD_DATA18/MMC1_DAT5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); also elsewhere on the board
GPMC_AD14: BBB.P8.16 (GPIO1_14/GPMC_AD14/LCD_DATA17/MMC1_DAT6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); also elsewhere on the board
GPMC_AD15: BBB.P8.15 (GPIO1_15/GPMC_AD15/LCD_DATA16/MMC1_DAT7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); also elsewhere on the board
GPMC_ADVN: BBB.P8.7 (TIMER4/GPMC_ADVN_ALE); also elsewhere on the board
GPMC_BE0N: BBB.P8.9 (TIMER5/GPMC_BE0N_CLE); also elsewhere on the board
GPMC_BE1N: BBB.P9.12 (GPIO1_28/GPMC_BE1N/MII2_COL/GPMC_CSN6); also elsewhere on the board
GPMC_CLK: BBB.P8.18 (GPIO2_1/GPMC_CLK_MUX0/LCD_MEMORY_CLK/GP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); also elsewhere on the board
GPMC_CSN1: BBB.P8.21 (GPIO1_30/GPMC_CSN1/GPMC_CLK/MMC1_CLK); also elsewhere on the board
GPMC_OEN: BBB.P8.8 (TIMER7/GPMC_OEN_REN); also elsewhere on the board
GPMC_WE1N: BBB.P8.10 (TIMER6/GPMC_WEN); also elsewhere on the board

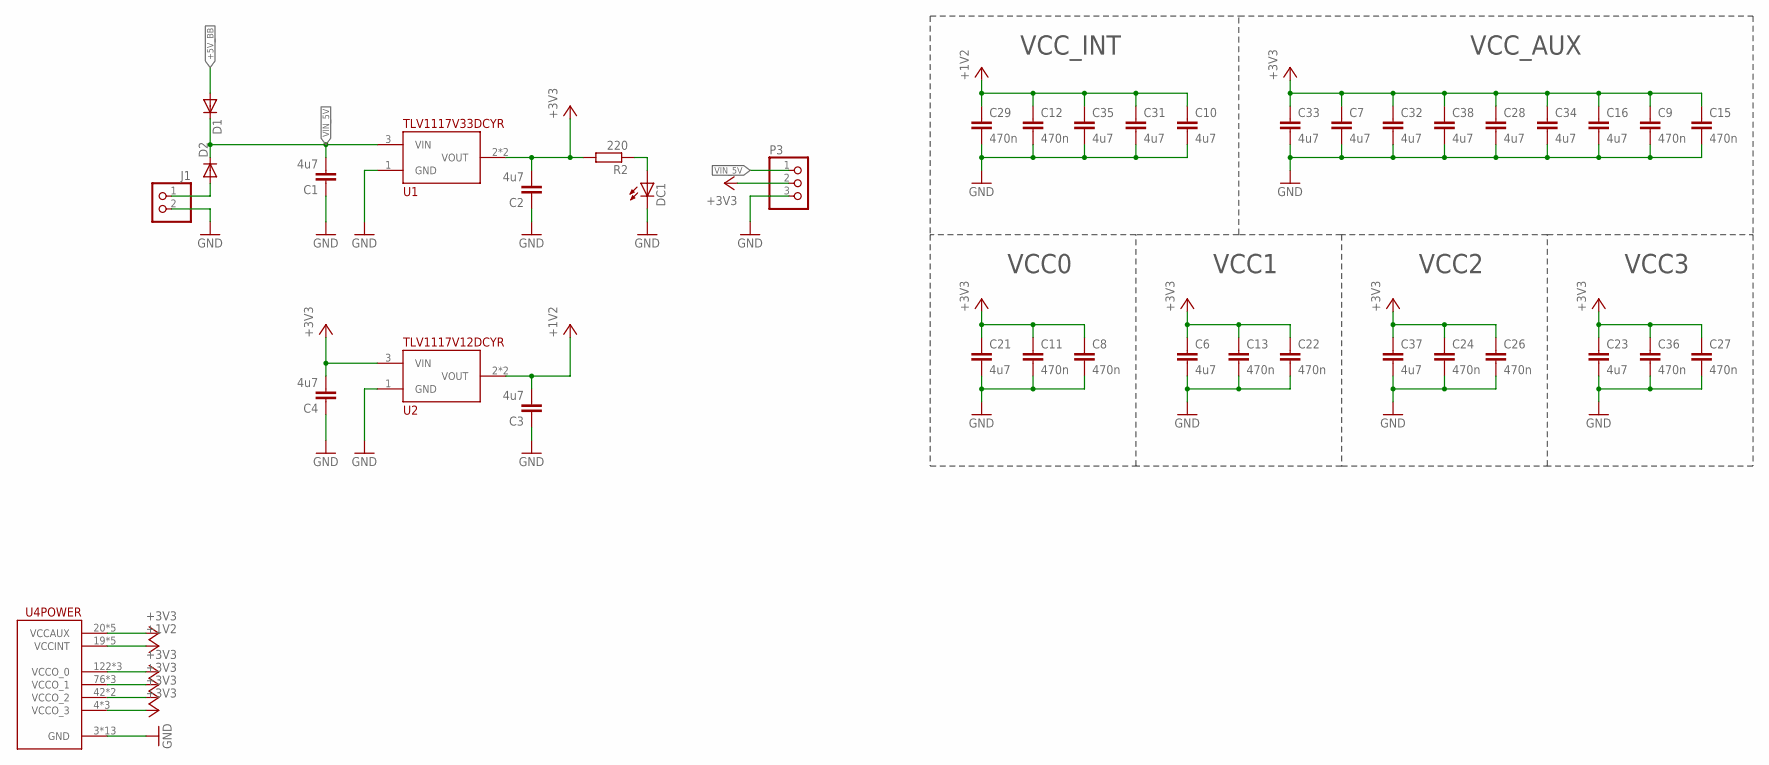
[picture p21: schematic led-matrix-cape.sch, sheet 2]

Parts:
C1, C2, C3, C4, C6, C7, C10, C16, C21, C23, C28, C31, C32, C33, C34, C35, C37, C38: 4u7; C0603
C8, C9, C11, C12, C13, C15, C22, C24, C26, C27, C29, C36: 470n; C0603
D1, D2: DIODE-SOD123; SOD123
DC1: LEDCHIP-LED0805; CHIP-LED0805
J1: PINHD-1X2; 1X02
P3: PINHD-1X3; 1X03
R2: 220; R0805
U1: TLV1117V33DCYR; SOT223
U2: TLV1117V12DCYR; SOT223
U4: XC6SLX9-2TQG144C; TQFP144

Connections:
+1V2: C3.2, C10.1, C12.1, C29.1, C31.1, C35.1, U2.2 (VOUT), U2.4 (VOUT), U4.19 (VCCINT), U4.28 (VCCINT), U4.52 (VCCINT), U4.89 (VCCINT), U4.128 (VCCINT)
+3V3: C2.2, C4.2, C6.1, C7.1, C8.1, C9.1, C11.1, C13.1, C15.1, C16.1, C21.1, C22.1, C23.1, C24.1, C26.1, C27.1, C28.1, C32.1, C33.1, C34.1, C36.1, C37.1, C38.1, P3.2, R2.2, U1.2 (VOUT), U1.4 (VOUT), U2.3 (VIN), U4.4 (VCCO_3), U4.18 (VCCO_3), U4.20 (VCCAUX), U4.31 (VCCO_3), U4.36 (VCCAUX), U4.42 (VCCO_2), U4.53 (VCCAUX), U4.63 (VCCO_2), U4.76 (VCCO_1), U4.86 (VCCO_1), U4.90 (VCCAUX), U4.103 (VCCO_1), U4.122 (VCCO_0), U4.125 (VCCO_0), U4.129 (VCCAUX), U4.135 (VCCO_0); also elsewhere on the board
+5V_BB: D1.A; also elsewhere on the board
GND: C1.1, C2.1, C3.1, C4.1, C6.2, C7.2, C8.2, C9.2, C10.2, C11.2, C12.2, C13.2, C15.2, C16.2, C21.2, C22.2, C23.2, C24.2, C26.2, C27.2, C28.2, C29.2, C31.2, C32.2, C33.2, C34.2, C35.2, C36.2, C37.2, C38.2, DC1.C, J1.2, P3.3, U1.1 (GND), U2.1 (GND), U4.3 (GND), U4.13 (GND), U4.25 (GND), U4.49 (GND), U4.54 (GND), U4.68 (GND), U4.77 (GND), U4.91 (GND), U4.96 (GND), U4.108 (GND), U4.113 (GND), U4.130 (GND), U4.136 (GND); also elsewhere on the board
unnamed: D2.A, J1.1
unnamed: DC1.A, R2.1
VIN_5V: C1.2, D1.C, D2.C, P3.1, U1.3 (VIN)

Notes on the sheet:
VCC_INT
VCC_AUX
VCC0
VCC1
VCC2
VCC3

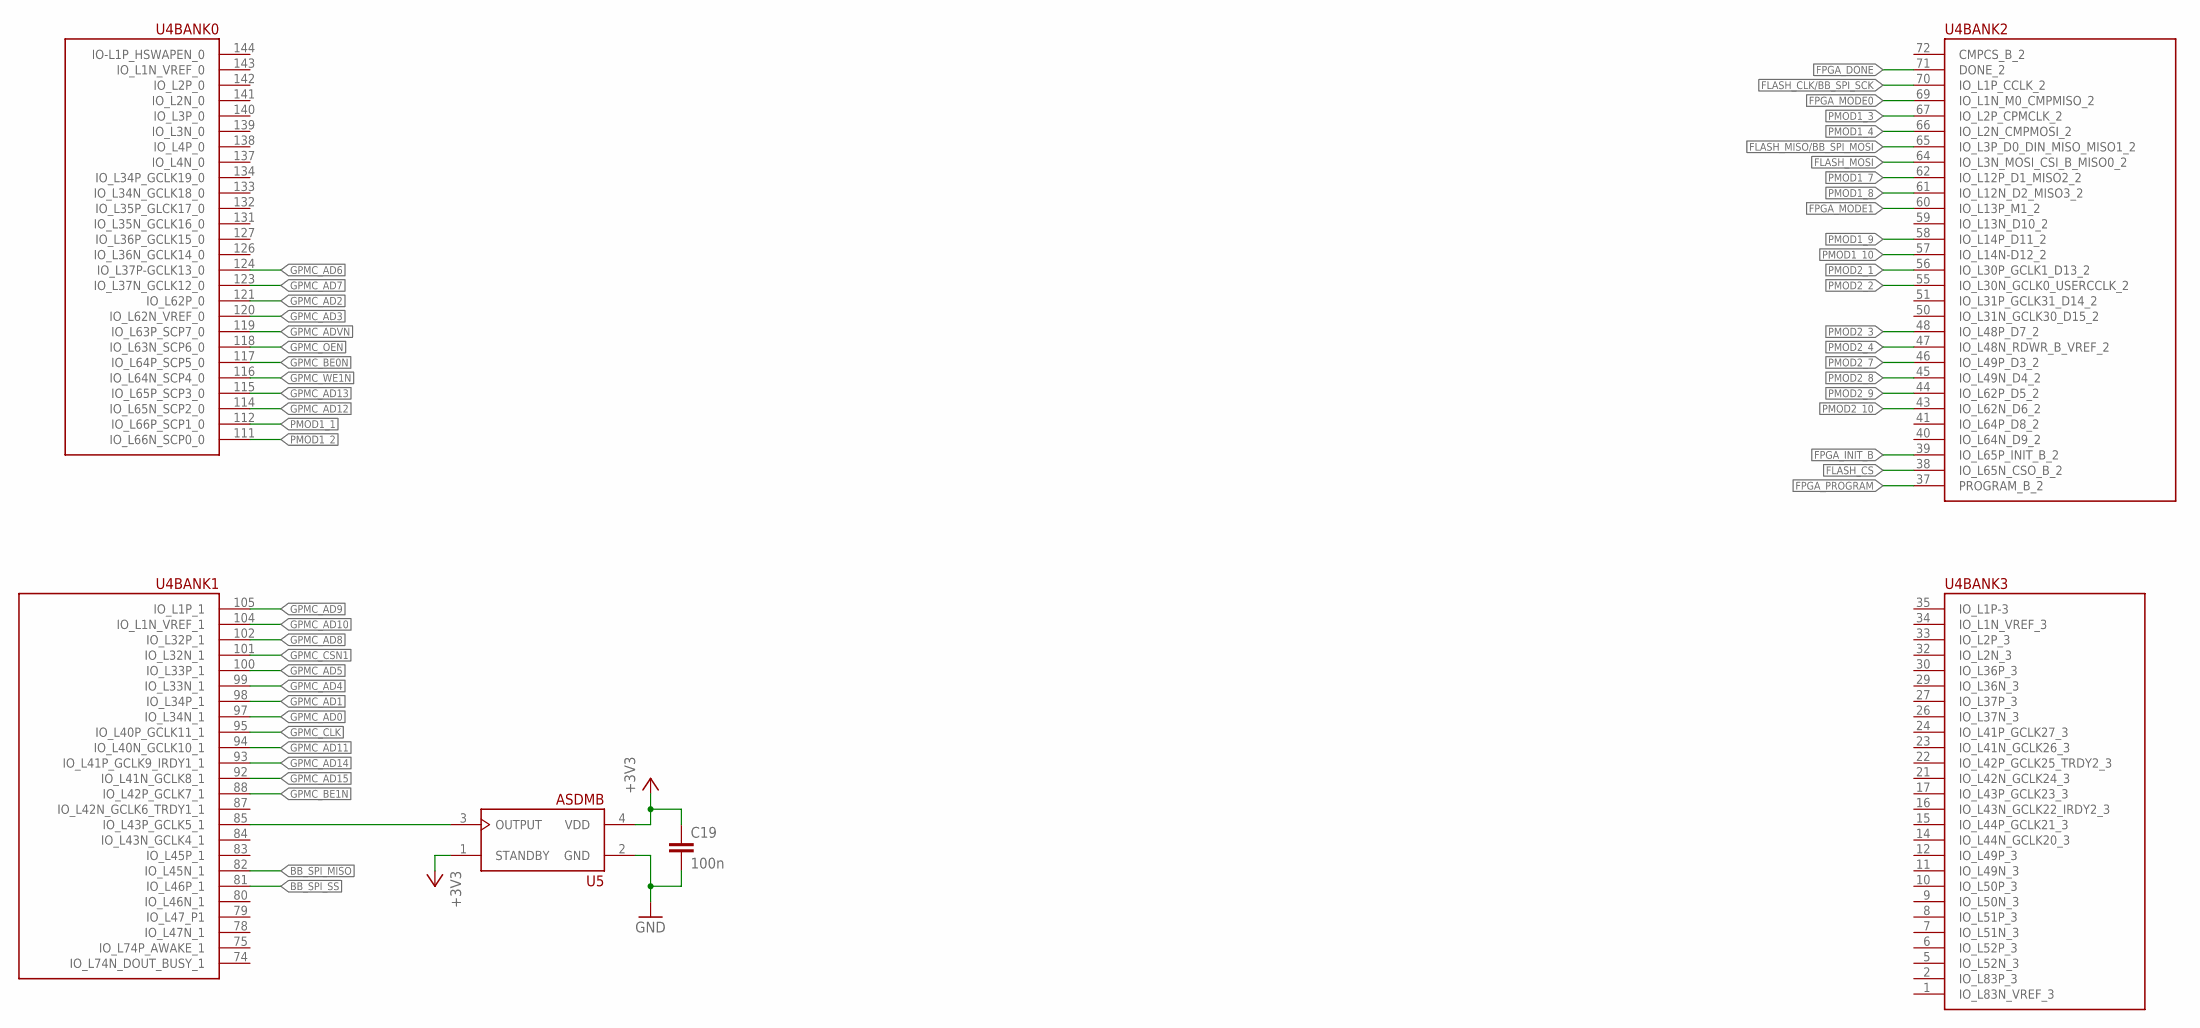
[picture p22: schematic led-matrix-cape.sch, sheet 3]

Parts:
C19: 100n; C0603
U4: XC6SLX9-2TQG144C; TQFP144
U5: ASDMB

Connections:
+3V3: C19.1, U5.1 (STANDBY), U5.4 (VDD); also elsewhere on the board
BB_SPI_MISO: U4.82 (IO_L45N_1); also elsewhere on the board
BB_SPI_SS: U4.81 (IO_L46P_1); also elsewhere on the board
FLASH_CLK/BB_SPI_SCK: U4.70 (IO_L1P_CCLK_2); also elsewhere on the board
FLASH_CS: U4.38 (IO_L65N_CSO_B_2); also elsewhere on the board
FLASH_MISO/BB_SPI_MOSI: U4.65 (IO_L3P_D0_DIN_MISO_MISO1_2); also elsewhere on the board
FLASH_MOSI: U4.64 (IO_L3N_MOSI_CSI_B_MISO0_2); also elsewhere on the board
FPGA_DONE: U4.71 (DONE_2); also elsewhere on the board
FPGA_INIT_B: U4.39 (IO_L65P_INIT_B_2); also elsewhere on the board
FPGA_MODE0: U4.69 (IO_L1N_M0_CMPMISO_2); also elsewhere on the board
FPGA_MODE1: U4.60 (IO_L13P_M1_2); also elsewhere on the board
FPGA_PROGRAM: U4.37 (PROGRAM_B_2); also elsewhere on the board
GND: C19.2, U5.2 (GND); also elsewhere on the board
GPMC_AD0: U4.97 (IO_L34N_1); also elsewhere on the board
GPMC_AD1: U4.98 (IO_L34P_1); also elsewhere on the board
GPMC_AD2: U4.121 (IO_L62P_0); also elsewhere on the board
GPMC_AD3: U4.120 (IO_L62N_VREF_0); also elsewhere on the board
GPMC_AD4: U4.99 (IO_L33N_1); also elsewhere on the board
GPMC_AD5: U4.100 (IO_L33P_1); also elsewhere on the board
GPMC_AD6: U4.124 (IO_L37P-GCLK13_0); also elsewhere on the board
GPMC_AD7: U4.123 (IO_L37N_GCLK12_0); also elsewhere on the board
GPMC_AD8: U4.102 (IO_L32P_1); also elsewhere on the board
GPMC_AD9: U4.105 (IO_L1P_1); also elsewhere on the board
GPMC_AD10: U4.104 (IO_L1N_VREF_1); also elsewhere on the board
GPMC_AD11: U4.94 (IO_L40N_GCLK10_1); also elsewhere on the board
GPMC_AD12: U4.114 (IO_L65N_SCP2_0); also elsewhere on the board
GPMC_AD13: U4.115 (IO_L65P_SCP3_0); also elsewhere on the board
GPMC_AD14: U4.93 (IO_L41P_GCLK9_IRDY1_1); also elsewhere on the board
GPMC_AD15: U4.92 (IO_L41N_GCLK8_1); also elsewhere on the board
GPMC_ADVN: U4.119 (IO_L63P_SCP7_0); also elsewhere on the board
GPMC_BE0N: U4.117 (IO_L64P_SCP5_0); also elsewhere on the board
GPMC_BE1N: U4.88 (IO_L42P_GCLK7_1); also elsewhere on the board
GPMC_CLK: U4.95 (IO_L40P_GCLK11_1); also elsewhere on the board
GPMC_CSN1: U4.101 (IO_L32N_1); also elsewhere on the board
GPMC_OEN: U4.118 (IO_L63N_SCP6_0); also elsewhere on the board
GPMC_WE1N: U4.116 (IO_L64N_SCP4_0); also elsewhere on the board
OSC_FPGA: U4.85 (IO_L43P_GCLK5_1), U5.3 (OUTPUT)
PMOD1_1: U4.112 (IO_L66P_SCP1_0); also elsewhere on the board
PMOD1_2: U4.111 (IO_L66N_SCP0_0); also elsewhere on the board
PMOD1_3: U4.67 (IO_L2P_CPMCLK_2); also elsewhere on the board
PMOD1_4: U4.66 (IO_L2N_CMPMOSI_2); also elsewhere on the board
PMOD1_7: U4.62 (IO_L12P_D1_MISO2_2); also elsewhere on the board
PMOD1_8: U4.61 (IO_L12N_D2_MISO3_2); also elsewhere on the board
PMOD1_9: U4.58 (IO_L14P_D11_2); also elsewhere on the board
PMOD1_10: U4.57 (IO_L14N-D12_2); also elsewhere on the board
PMOD2_1: U4.56 (IO_L30P_GCLK1_D13_2); also elsewhere on the board
PMOD2_2: U4.55 (IO_L30N_GCLK0_USERCCLK_2); also elsewhere on the board
PMOD2_3: U4.48 (IO_L48P_D7_2); also elsewhere on the board
PMOD2_4: U4.47 (IO_L48N_RDWR_B_VREF_2); also elsewhere on the board
PMOD2_7: U4.46 (IO_L49P_D3_2); also elsewhere on the board
PMOD2_8: U4.45 (IO_L49N_D4_2); also elsewhere on the board
PMOD2_9: U4.44 (IO_L62P_D5_2); also elsewhere on the board
PMOD2_10: U4.43 (IO_L62N_D6_2); also elsewhere on the board

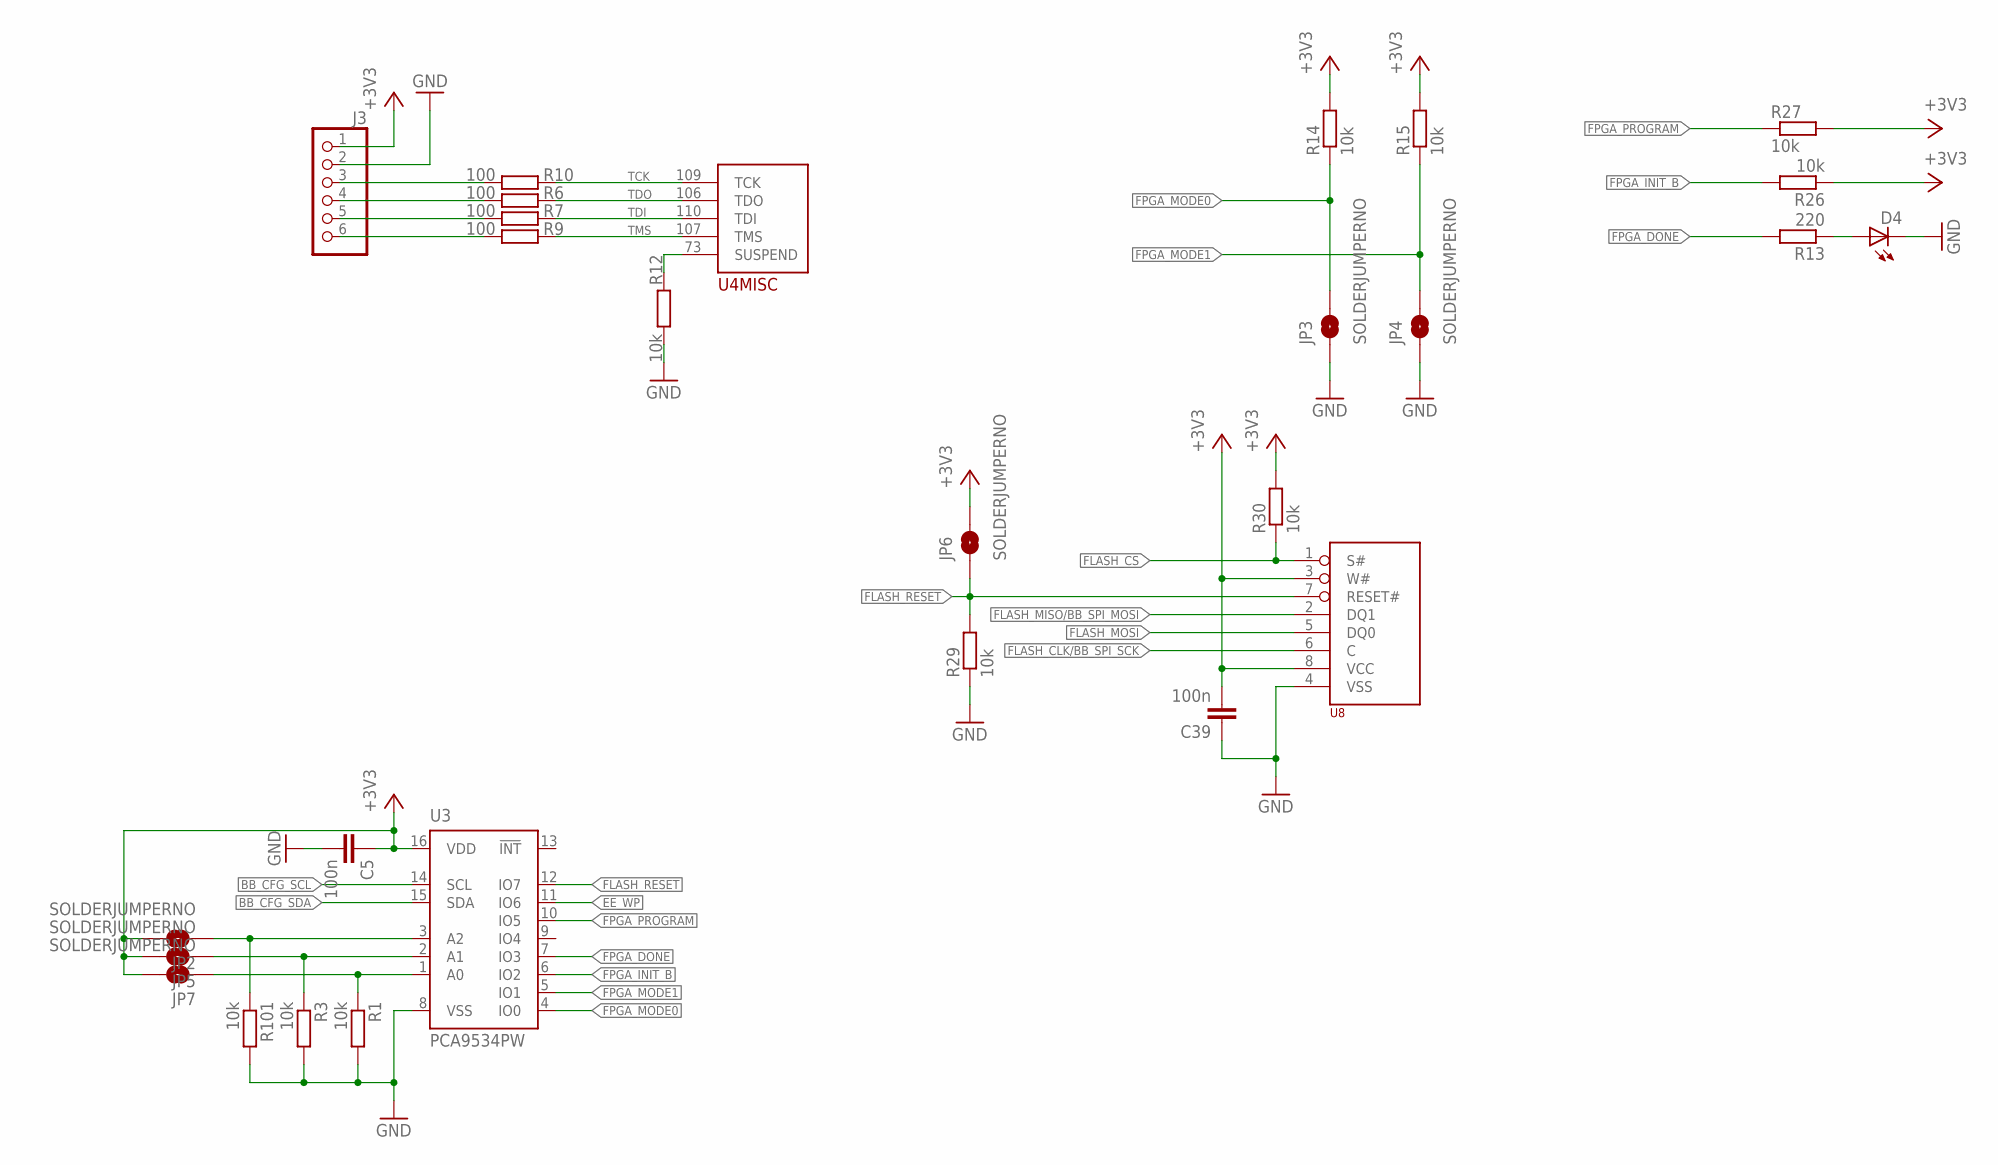
[picture p23: schematic led-matrix-cape.sch, sheet 4]

Parts:
C5, C39: 100n; C0603
D4: LEDCHIP-LED0805; CHIP-LED0805
J3: PINHD-1X6; 1X06
JP2, JP3, JP4, JP5, JP6, JP7: SOLDERJUMPERNO; SJ_2S-NO
R1, R3, R12, R14, R15, R26, R27, R30, R101: 10k; R0603
R6, R7, R9, R10: 100; R0603
R13: 220; R0603
R29: 10k; R0805
U3: PCA9534PW; TSSOP16
U4: XC6SLX9-2TQG144C; TQFP144
U8: M25PE16; SO8

Connections:
+3V3: C5.1, C39.2, J3.1, JP2.2, JP5.2, JP6.2, JP7.2, R14.2, R15.2, R26.1, R27.2, R30.2, U3.16 (VDD), U8.3 (W#), U8.8 (VCC); also elsewhere on the board
BB_CFG_SCL: U3.14 (SCL); also elsewhere on the board
BB_CFG_SDA: U3.15 (SDA); also elsewhere on the board
EE_WP: U3.11 (IO6)
FLASH_CLK/BB_SPI_SCK: U8.6 (C); also elsewhere on the board
FLASH_CS: R30.1, U8.1 (S#); also elsewhere on the board
FLASH_MISO/BB_SPI_MOSI: U8.2 (DQ1); also elsewhere on the board
FLASH_MOSI: U8.5 (DQ0); also elsewhere on the board
FLASH_RESET: JP6.1, R29.2, U3.12 (IO7), U8.7 (RESET#)
FPGA_DONE: R13.2, U3.7 (IO3); also elsewhere on the board
FPGA_INIT_B: R26.2, U3.6 (IO2); also elsewhere on the board
FPGA_MODE0: JP3.2, R14.1, U3.4 (IO0); also elsewhere on the board
FPGA_MODE1: JP4.2, R15.1, U3.5 (IO1); also elsewhere on the board
FPGA_PROGRAM: R27.1, U3.10 (IO5); also elsewhere on the board
GND: C5.2, C39.1, D4.C, J3.2, JP3.1, JP4.1, R1.2, R3.2, R12.1, R29.1, R101.2, U3.8 (VSS), U8.4 (VSS); also elsewhere on the board
unnamed: JP7.1, R1.1, U3.1 (A0)
unnamed: JP5.1, R3.1, U3.2 (A1)
unnamed: JP2.1, R101.1, U3.3 (A2)
unnamed: J3.3, R10.1
unnamed: J3.4, R6.1
unnamed: J3.5, R7.1
unnamed: J3.6, R9.1
unnamed: D4.A, R13.1
SUSPEND: R12.2, U4.73 (SUSPEND)
TCK: R10.2, U4.109 (TCK)
TDI: R7.2, U4.110 (TDI)
TDO: R6.2, U4.106 (TDO)
TMS: R9.2, U4.107 (TMS)

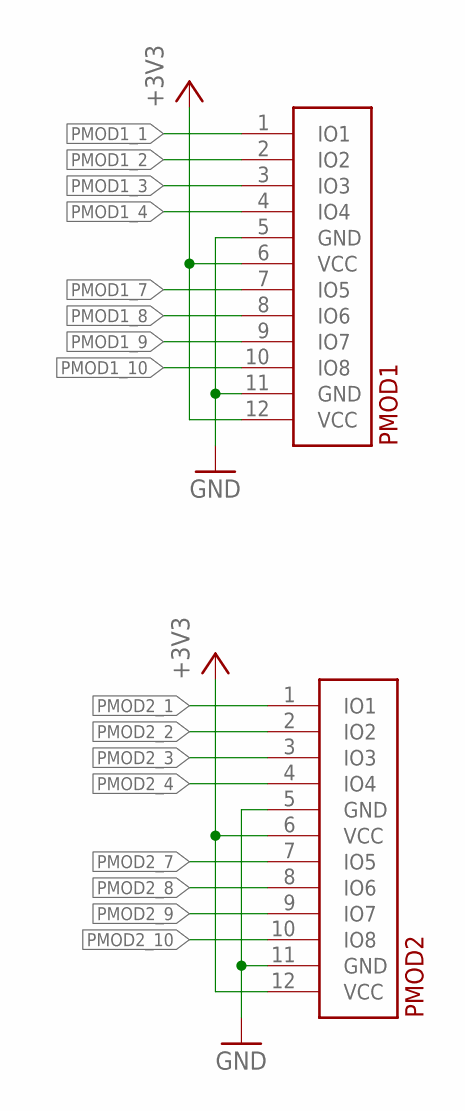
[picture p24: schematic led-matrix-cape.sch, sheet 5]

Parts:
PMOD1, PMOD2: PMOD_2_HOST

Connections:
+3V3: PMOD1.6 (VCC), PMOD1.12 (VCC), PMOD2.6 (VCC), PMOD2.12 (VCC); also elsewhere on the board
GND: PMOD1.5 (GND), PMOD1.11 (GND), PMOD2.5 (GND), PMOD2.11 (GND); also elsewhere on the board
PMOD1_1: PMOD1.1 (IO1); also elsewhere on the board
PMOD1_2: PMOD1.2 (IO2); also elsewhere on the board
PMOD1_3: PMOD1.3 (IO3); also elsewhere on the board
PMOD1_4: PMOD1.4 (IO4); also elsewhere on the board
PMOD1_7: PMOD1.7 (IO5); also elsewhere on the board
PMOD1_8: PMOD1.8 (IO6); also elsewhere on the board
PMOD1_9: PMOD1.9 (IO7); also elsewhere on the board
PMOD1_10: PMOD1.10 (IO8); also elsewhere on the board
PMOD2_1: PMOD2.1 (IO1); also elsewhere on the board
PMOD2_2: PMOD2.2 (IO2); also elsewhere on the board
PMOD2_3: PMOD2.3 (IO3); also elsewhere on the board
PMOD2_4: PMOD2.4 (IO4); also elsewhere on the board
PMOD2_7: PMOD2.7 (IO5); also elsewhere on the board
PMOD2_8: PMOD2.8 (IO6); also elsewhere on the board
PMOD2_9: PMOD2.9 (IO7); also elsewhere on the board
PMOD2_10: PMOD2.10 (IO8); also elsewhere on the board

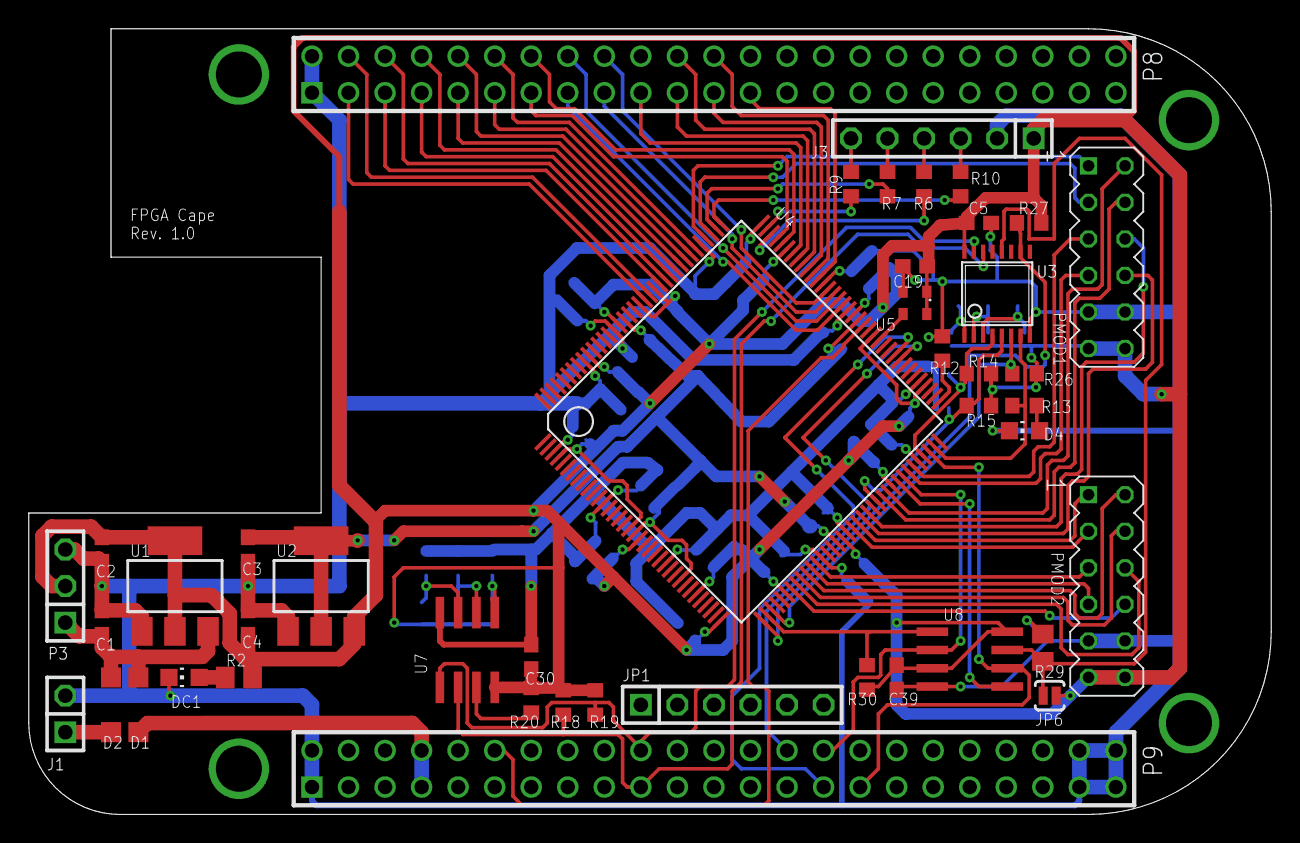
[picture p25: board led-matrix-cape.brd from above]

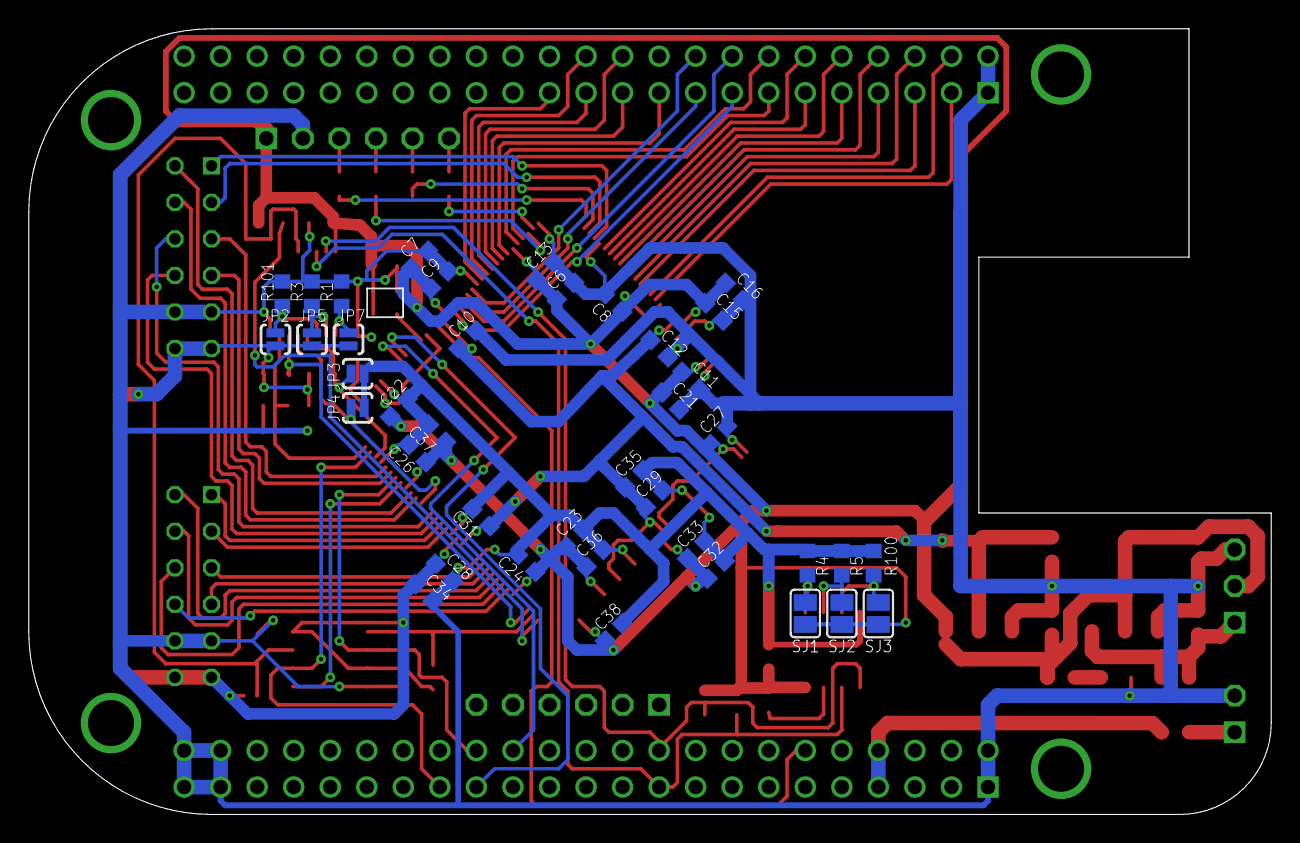
[picture p26: board led-matrix-cape.brd from below]

Board: 2 copper layers, 86.4 x 54.6 mm, 83 parts (40 on the bottom side), 78 nets.
