twam/led-display-hardware/(commit log)

2015-06-09 Rev 1.0 board
    [led-matrix-cape.brd, led-matrix-cape.sch]
2015-06-09 Rev 2.0 board
    [Pmod.sch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]
