twam/led-display-hardware/(notices)

Notices in the files:
Rev2.0/Rev2.0.sch:
(c) 2015 Tobias Müller, twam.info
parts and their libraries:
sparkfun: Licensing: CC v3.0 Share-Alike You are welcome to use this library for commercial purposes.
